we-are-mono/keyboard/assets/MONO65-logo.pdf

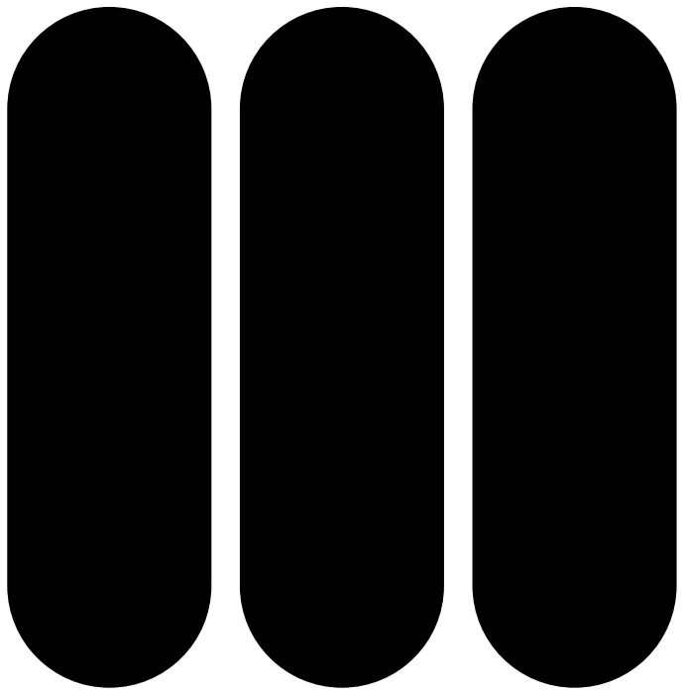
[picture p35: figure]
