we-are-mono/keyboard/electronics/MONO65/A2/fabricationFiles/BOM/MONO65_A2_BOM_NO_SWITCHES_Var_SCH/MONO65_A2_BOM_NO_SWITCHES_Var_SCH.pdf

Designator | Quantity | Description | Comment | Case/Package | Pins | Manufacturer | Manufacturer Part Number | Supplier 1 | Supplier Part Number 1
C1, C7, C8, C12, C13, C14, C15, C16 | 8 | SMD CAPACITOR,10u, 16V, X5R, 0603 | 10u 16V | 0603 | 2 | Murata | GRM188R61C106MA73D | Digi-Key | 490-7201-1-ND
C2, C4, C5, C6, C11 | 5 | SMD CAPACITOR, 100n, 50V, X7R, 0603 | 100n 50V | 0603 | 2 | TDK | CGA3E2X7R1H104K080AA | Digi-Key | 445-5666-1-ND
C3 | 1 | SMD CAPACITOR, 1µF, 25V, X7R, 0603 | 1u 25V | 0603 | 2 | KEMET | C0603C105K3RACTU | Digi-Key | 399-7376-1-ND
C9, C10 | 2 | SMD CAPACITOR, 22p, 50V, C0G/NP0, 0603 | 22p 50V | 0603 | 2 | Kyocera AVX | 06035A220JAT2A | Digi-Key | 478-1167-1-ND
D1, D2, D3, D4, D5, D6, D7, D8, D9, D10, D11, D12, D13, D14, D16, D17, D18, D19, D20, D21, D22, D23, D24, D25, D26, D27, D28, D29, D30, D32, D33, D35, D36, D37, D38, D39, D40, D41, D42, D43, D44, D45, D46, D48, D49, D50, D52, D53, D54, D55, D56, D57, D58, D59, D60, D61, D62, D63, D64, D65, D66, D68, D70, D72, D74, D75, D77, D78, D79 | 69 | Schottky Diode, Small Signal, Single, 40 V, 500 mA, 480 mV, 5A max. | SD0805S040 | 0805 | 2 | Kyocera AVX | SD0805S040S0R5 | Digi-Key | 478-7802-1-ND
F1 | 1 | PTC Resettable Fuse 0.5A (hold) 1A (trip) 15VDC 100A peak 0.6W 0.1sek 0.15Ohm SMD 1206 | 0.5A 15VDC | 1206 | 2 | Littelfuse | 1206L050/15YR | Digi-Key | F3733CT-ND
IC1 | 1 | MCU 8-bit AVR, 16MHz, 128KB Flash, 64-QFN 9x9mm (PS package) | AT90USB128 QFN-64 | | 65 | Microchip / Atmel | AT90USB1286-MU | RSComponents | 1278162
K1 | 1 | 4pin PHD 1mm SMD JST - SM04B-SRSS-TB - Pin Header, Wire-to-Board, 1 Rows, 4 Contacts, SR Series | SM04B-SRSS-TB | | 5 | JST | SM04B-SRSS-TB | Digi-Key | 455-1422-1-ND
Q1, Q2 | 2 | N-Channel MOSFET, 680 mA, 25 V, SOT-23-3, ON Semiconductor FDV303N | FDV303N | SOT-23 | 3 | ON Semiconductor / Fairchild | FDV303N | Digi-Key | FDV303NCT-ND
R1, R2 | 2 | SMD RESISTOR 22R 1% 0603 0.1W | 22R 1% | 0603 | 2 | Yageo | RC0603FR-0722RL | Digi-Key | 311-22.0HRCT-ND
R3, R5, R6, R7, R8, R10, R94 | 7 | SMD RESISTOR 0R 1% 0603 0.1W | 0R 1% | 0603 | 2 | Yageo | RC0603JR-070RL | Digi-Key | 311-0.0GRDKR-ND
R4, R9, R14, R16 | 4 | SMD RESISTOR 10k 1% 0603 0.1W | 10k 1% | 0603 | 2 | Panasonic | ERJ-3EKF1002V | Digi-Key | P10.0KHDKR-ND
R11, R13, R15, R17, R18, R19, R20, R21, R22, R23, R24, R25, R26, R27, R28, R29, R30, R32, R33, R34, R35, R36, R37, R38, R39, R40, R41, R42, R43, R44, R45, R46, R47, R48, R49, R50, R51, R52, R53, R54, R55, R56, R57, R58, R59, R61, R63, R64, R66, R67, R68, R69, R70, R71, R72, R73, R74, R75, R76, R77, R78, R79, R80, R82, R84, R86, R88, R89, R91, R92, R93 | 71 | SMD RESISTOR 470R 1% 0603 0.1W | 470R 1% | 0603 | 2 | Yageo | RC0603FR-07470RL | Digi-Key | 311-470HRCT-ND
SW80 | 1 | WS-TASV J-Bend SMT Tact Switch 3.7x3.7mm. 12 V (DC) 50mA. 500000 Cycles. | WS-TASV 3.7x3.7mm | | 4 | Wurth Electronics | 430173003816 | Mouser | 710-430173003816
XC1 | 1 | Crystal Resonator, 16MHz, 10pF, 3.2mm X 2.5mm, SMD | 16MHz 10ppmSMD 3225 | | 4 | Multicomp | MCSJK-7U-16.00-10-10-80-B-10 | Farnell | 2853934
