we-are-mono/keyboard/electronics/MONO65_DB/A1/fabricationFiles/BOM/MONO65_DB_A1_BOM_FULL_Var_SCH/MONO65_DB_A1_BOM_FULL_Var_SCH.pdf

Designator | Quantity | Description | Comment | Case/Package | Pins | Manufacturer | Manufacturer Part Number | Supplier 1 | Supplier Part Number 1
C1 | 1 | SMD CAPACITOR, 4.7n, 1kV, X7R, 0805 | 4n7 1kV | 0805 | 2 | KEMET | C0805C472KDRACTU | Farnell | 3299100
D1 | 1 | TVS ESD DIODE - PRTR5V0U2X - Ultra low capacitance double rail-to-rail ESD protection diode | PRTR5V0U2X,215 | SOT143B | 4 | Nexperia | PRTR5V0U2X,215 | Digi-Key | 1727-3884-6-ND
F1 | 1 | PTC Resettable Fuse 1.1A(hold) 2.2A(trip) 16VDC 100A 0.8W 0.1sek 0.06Ohm SMD 1206 | 1.1A 16VDC PTC | 1206 | 2 | Littelfuse | 1206L110/16WR | Digi-Key | 18-1206L110/16WRCT-ND
K1 | 1 | USB2.0 Type-C 24P SMD Right Angle SMD | USB-C | | 13 | Molex | 217179-0001 | Avnet | 35AJ1973
K2 | 1 | 4pin PHD 1mm SMD JST - SM04B-SRSS-TB - Pin Header, Wire-to-Board, 1 Rows, 4 Contacts, SR Series SM04B-SRSS-TB | | | 5 | JST | SM04B-SRSS-TB | Digi-Key | 455-1422-1-ND
R1, R2 | 2 | SMD RESISTOR 5.1k 1% 0603 0.1W | 5k1 1% | 0603 | 2 | Yageo | RC0603FR-075K1L | Farnell | 3495881
R3 | 1 | SMD RESISTOR 1M 1% 0603 0.1W | 1M 1% | 0603 | 2 | Yageo | RC0603FR-071ML | Digi-Key | 311-1.00MHRCT-ND
