we-are-mono/keyboard/electronics/MONO65/A2/fabricationFiles/3D step/MONO65_A2_3D_step_FULL_Var_SCH.step

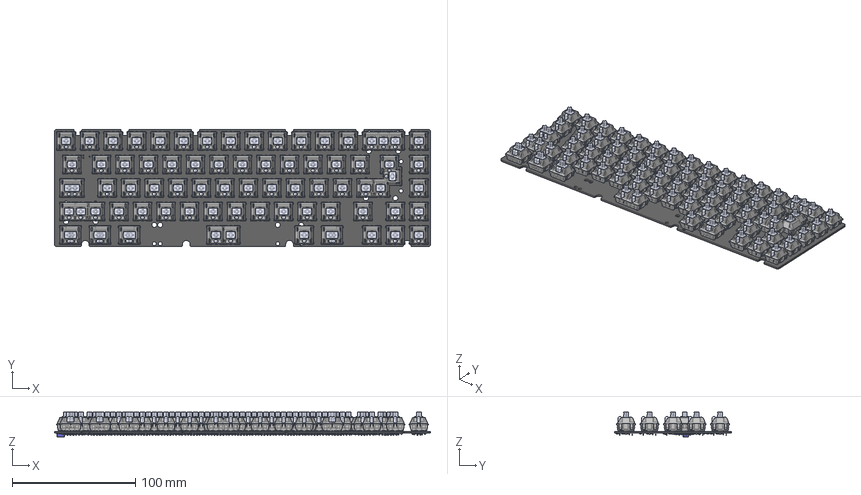
[picture p36: CAD file, 2025-07-09]
electronics/MONO65/A2/fabricationFiles/3D step/MONO65_A2_3D_step_FULL_Var_SCH.step
304.6 x 95.1 x 20.1 mm
Open_CASCADE_STEP_translator_6.8_2.1.1 x 16
Open_CASCADE_STEP_translator_6.8_2.1.2 x 16
Open_CASCADE_STEP_translator_6.8_2.2.1 x 16
Mid_Body x 84
Open_CASCADE_STEP_translator_6.8_1.2.1 x 168
Mark x 84
Housing x 5
pressure_plate
Open_CASCADE_STEP_translator_6.8_7.1.1 x 2
Leader x 6
User_Library-D0805 x 69
User_Library-SMD-3225_4P
SM04B-SRSS-TB
User_Library-0ZCJ0035FF2G
Open_CASCADE_STEP_translator_6.8_21.1
Open_CASCADE_STEP_translator_6.8_21.2.1
Thermal_Shape
Open_CASCADE_STEP_translator_6.8_21.4.1 x 64
MX_Series-Cherry_Key x 79
