we-are-mono/keyboard/assets/MONO65-logo.dxf

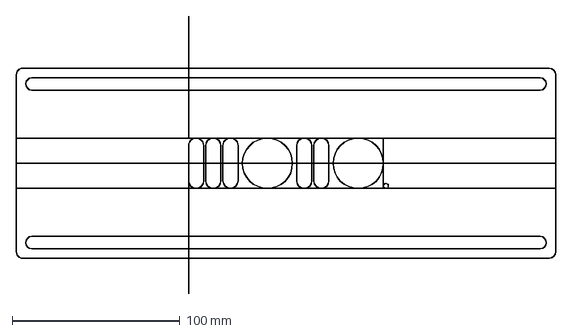
[picture p37: CAD file, 2025-07-09]
assets/MONO65-logo.dxf
321.8 x 165.4 mm
