we-are-mono/keyboard/enclosure/MONO65-keyboard-cover.step

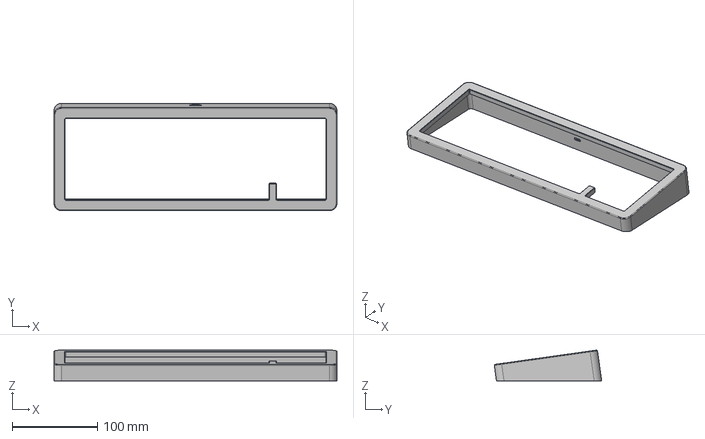
[picture p39: CAD file, 2025-07-09]
enclosure/MONO65-keyboard-cover.step
331.8 x 126.0 x 36.1 mm
