we-are-mono/keyboard/feet-gaskets/MONO65-keyboard-gasket.dxf

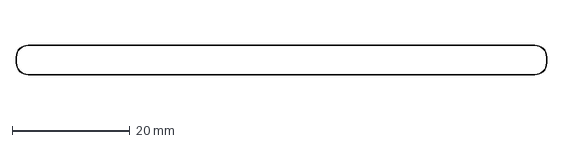
[picture p40: CAD file, 2025-07-09]
feet-gaskets/MONO65-keyboard-gasket.dxf
90.1 x 5.00 mm
