we-are-mono/keyboard/enclosure/MONO65-keyboard-bottom.step

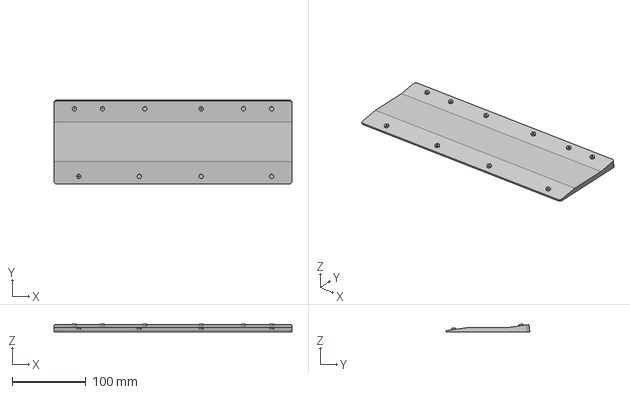
[picture p41: CAD file, 2025-07-09]
enclosure/MONO65-keyboard-bottom.step
321.8 x 113.6 x 11.2 mm
