we-are-mono/keyboard/enclosure/MONO65-keyboard-middle.step

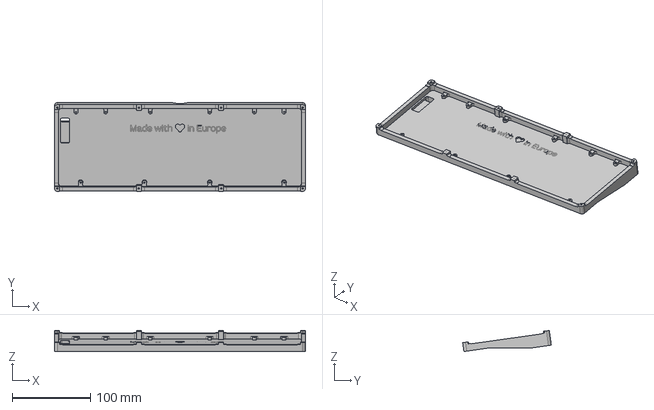
[picture p42: CAD file, 2025-07-09]
enclosure/MONO65-keyboard-middle.step
321.8 x 113.8 x 27.0 mm
