we-are-mono/keyboard/(list of files, cad)

Other CAD files:
enclosure/MONO65-keyboard-bottom.iges
enclosure/MONO65-keyboard-cover.iges
enclosure/MONO65-keyboard-middle.iges
