we-are-mono/keyboard/electronics/MONO65_JST_CAB/A1/fabricationFiles/MONO-65-JST-Cable-4-wires-180-mm.pdf

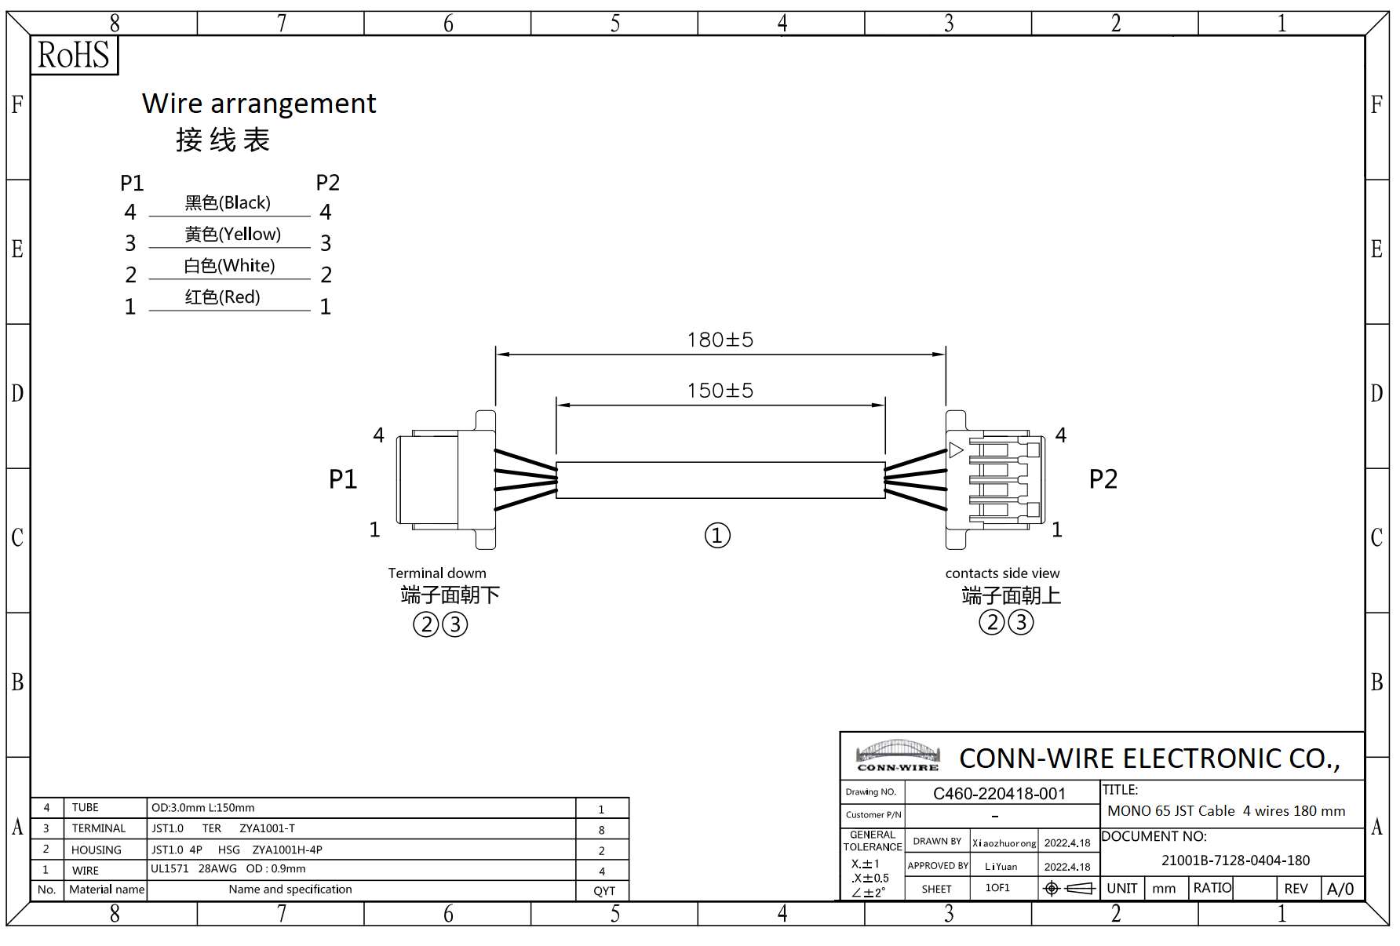
[picture p43: page 1]
