we-are-mono/keyboard/electronics/MONO65_JST_CAB/A1/fabricationFiles/MONO65_JST_CAB_A1_cable_specification.pdf

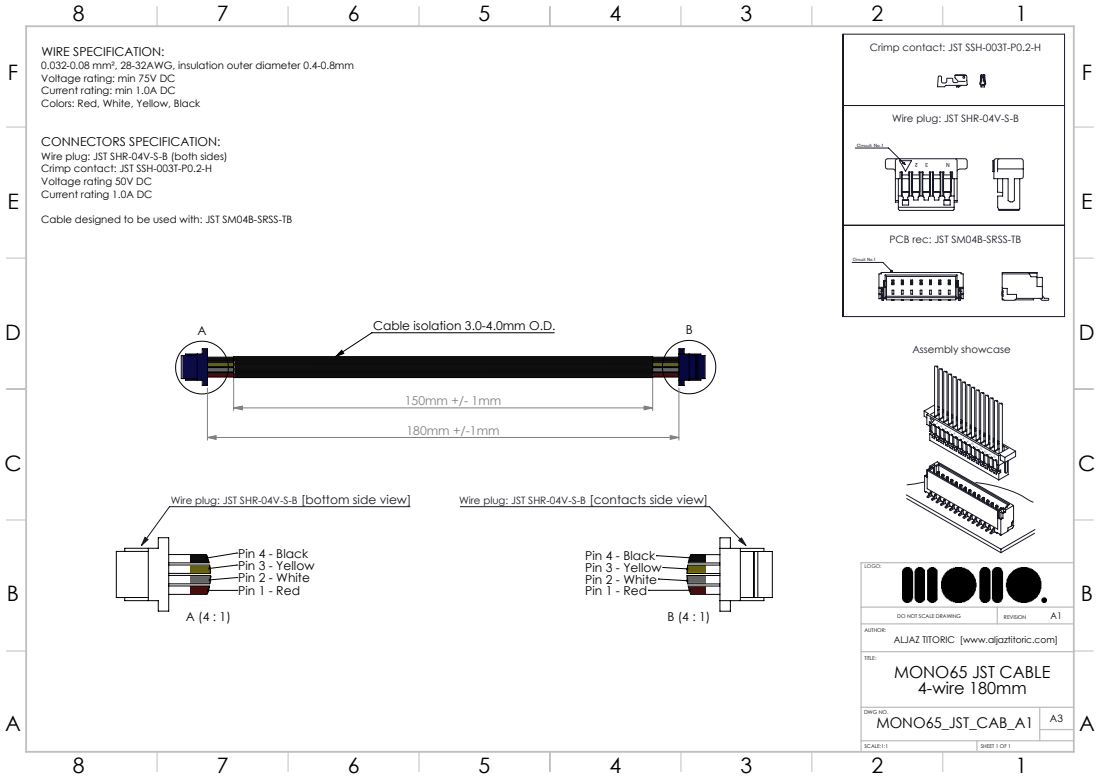
[picture p44: page 1]
Circuit No.1; Cable isolation 3.0-4.0mm O.D.; Pin 4 - Black Pin 3 - Yellow Pin 2 - White Pin 1 - Red; Pin 1 - Red; Pin 2 - White; Pin 3 - Yellow; Pin 4 - Black; Assembly showcase; Wire plug: JST SHR-04V-S-B [bottom side view]; Wire plug: JST SHR-04V-S-B [contacts side view]; DO NOT SCALE DRAWING; REVISION; DWG NO.; SCALE:1:1; SHEET 1 OF 1

Crimp contact: JST SSH-003T-P0.2-H

WIRE SPECIFICATION:
0.032-0.08 mm², 28-32AWG, insulation outer diameter 0.4-0.8mm
Voltage rating: min 75V DC
Current rating: min 1.0A DC
Colors: Red, White, Yellow, Black

Wire plug: JST SHR-04V-S-B

CONNECTORS SPECIFICATION:
Wire plug: JST SHR-04V-S-B (both sides)
Voltage rating 50V DC
Current rating 1.0A DC
Cable designed to be used with: JST SM04B-SRSS-TB

PCB rec: JST SM04B-SRSS-TB

ALJAZ TITORIC [www.aljaztitoric.com]
MONO65 JST CABLE
4-wire 180mm
