we-are-mono/keyboard/electronics/MONO65/A2/fabricationFiles/Schematic/MONO65_A2_Schematic_NO_SWITCHES_Var_SCH/MONO65_A2_Schematic_NO_SWITCHES_Var_SCH.PDF

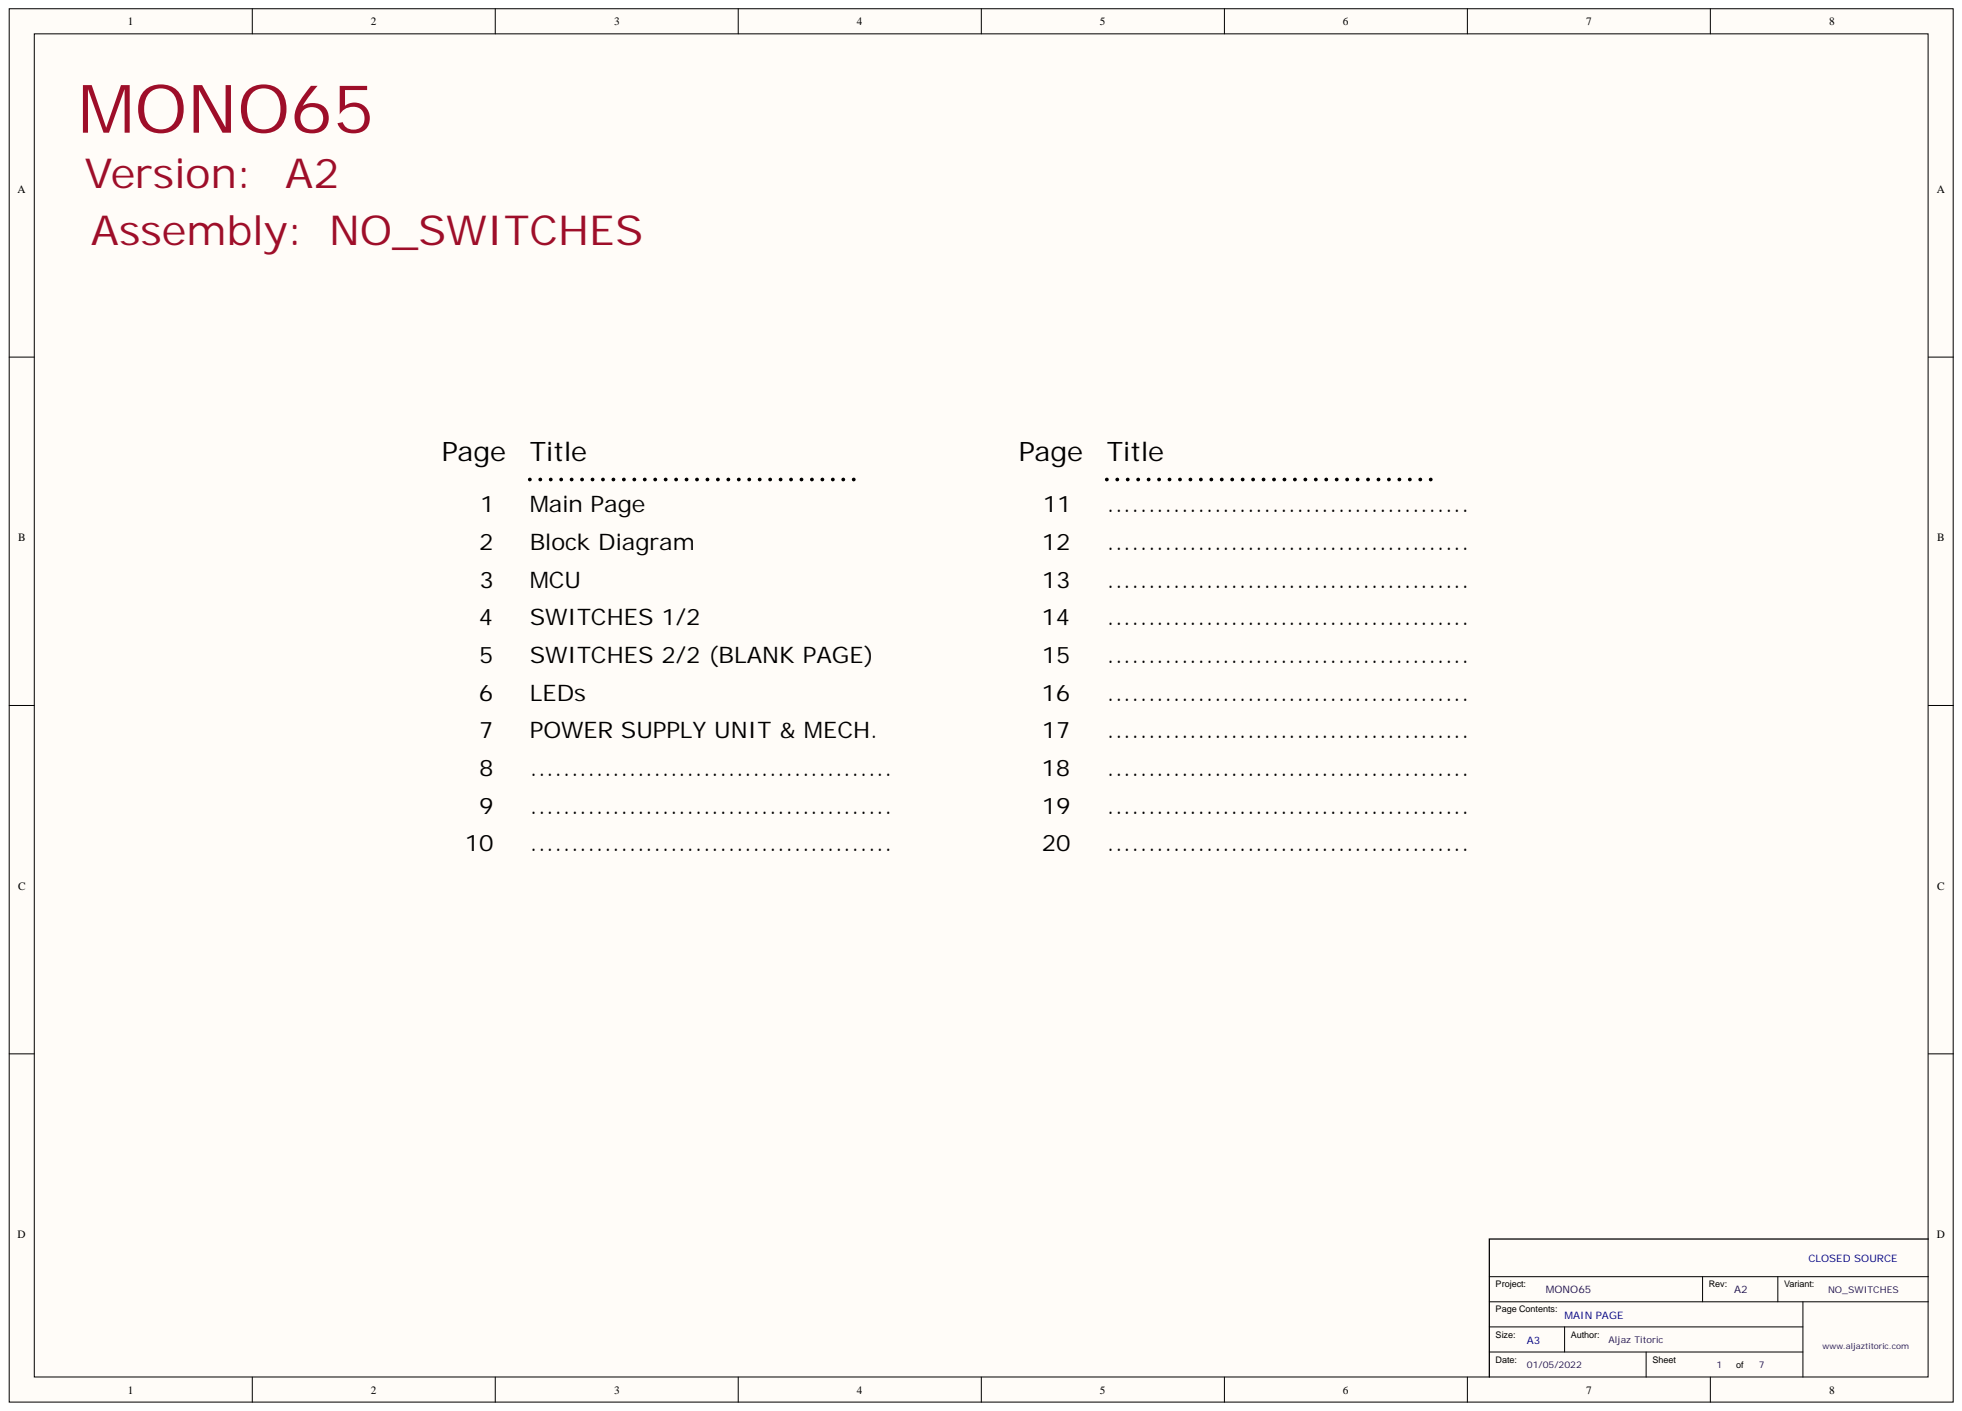
[picture p45: page 1]

Project: MONO65 | Rev: A2 | Variant: NO_SWITCHES

Page Contents: MAIN PAGE | www.aljaztitoric.com

A3 Size: | Author: Aljaz Titoric

Date: | Sheet 1 of 7

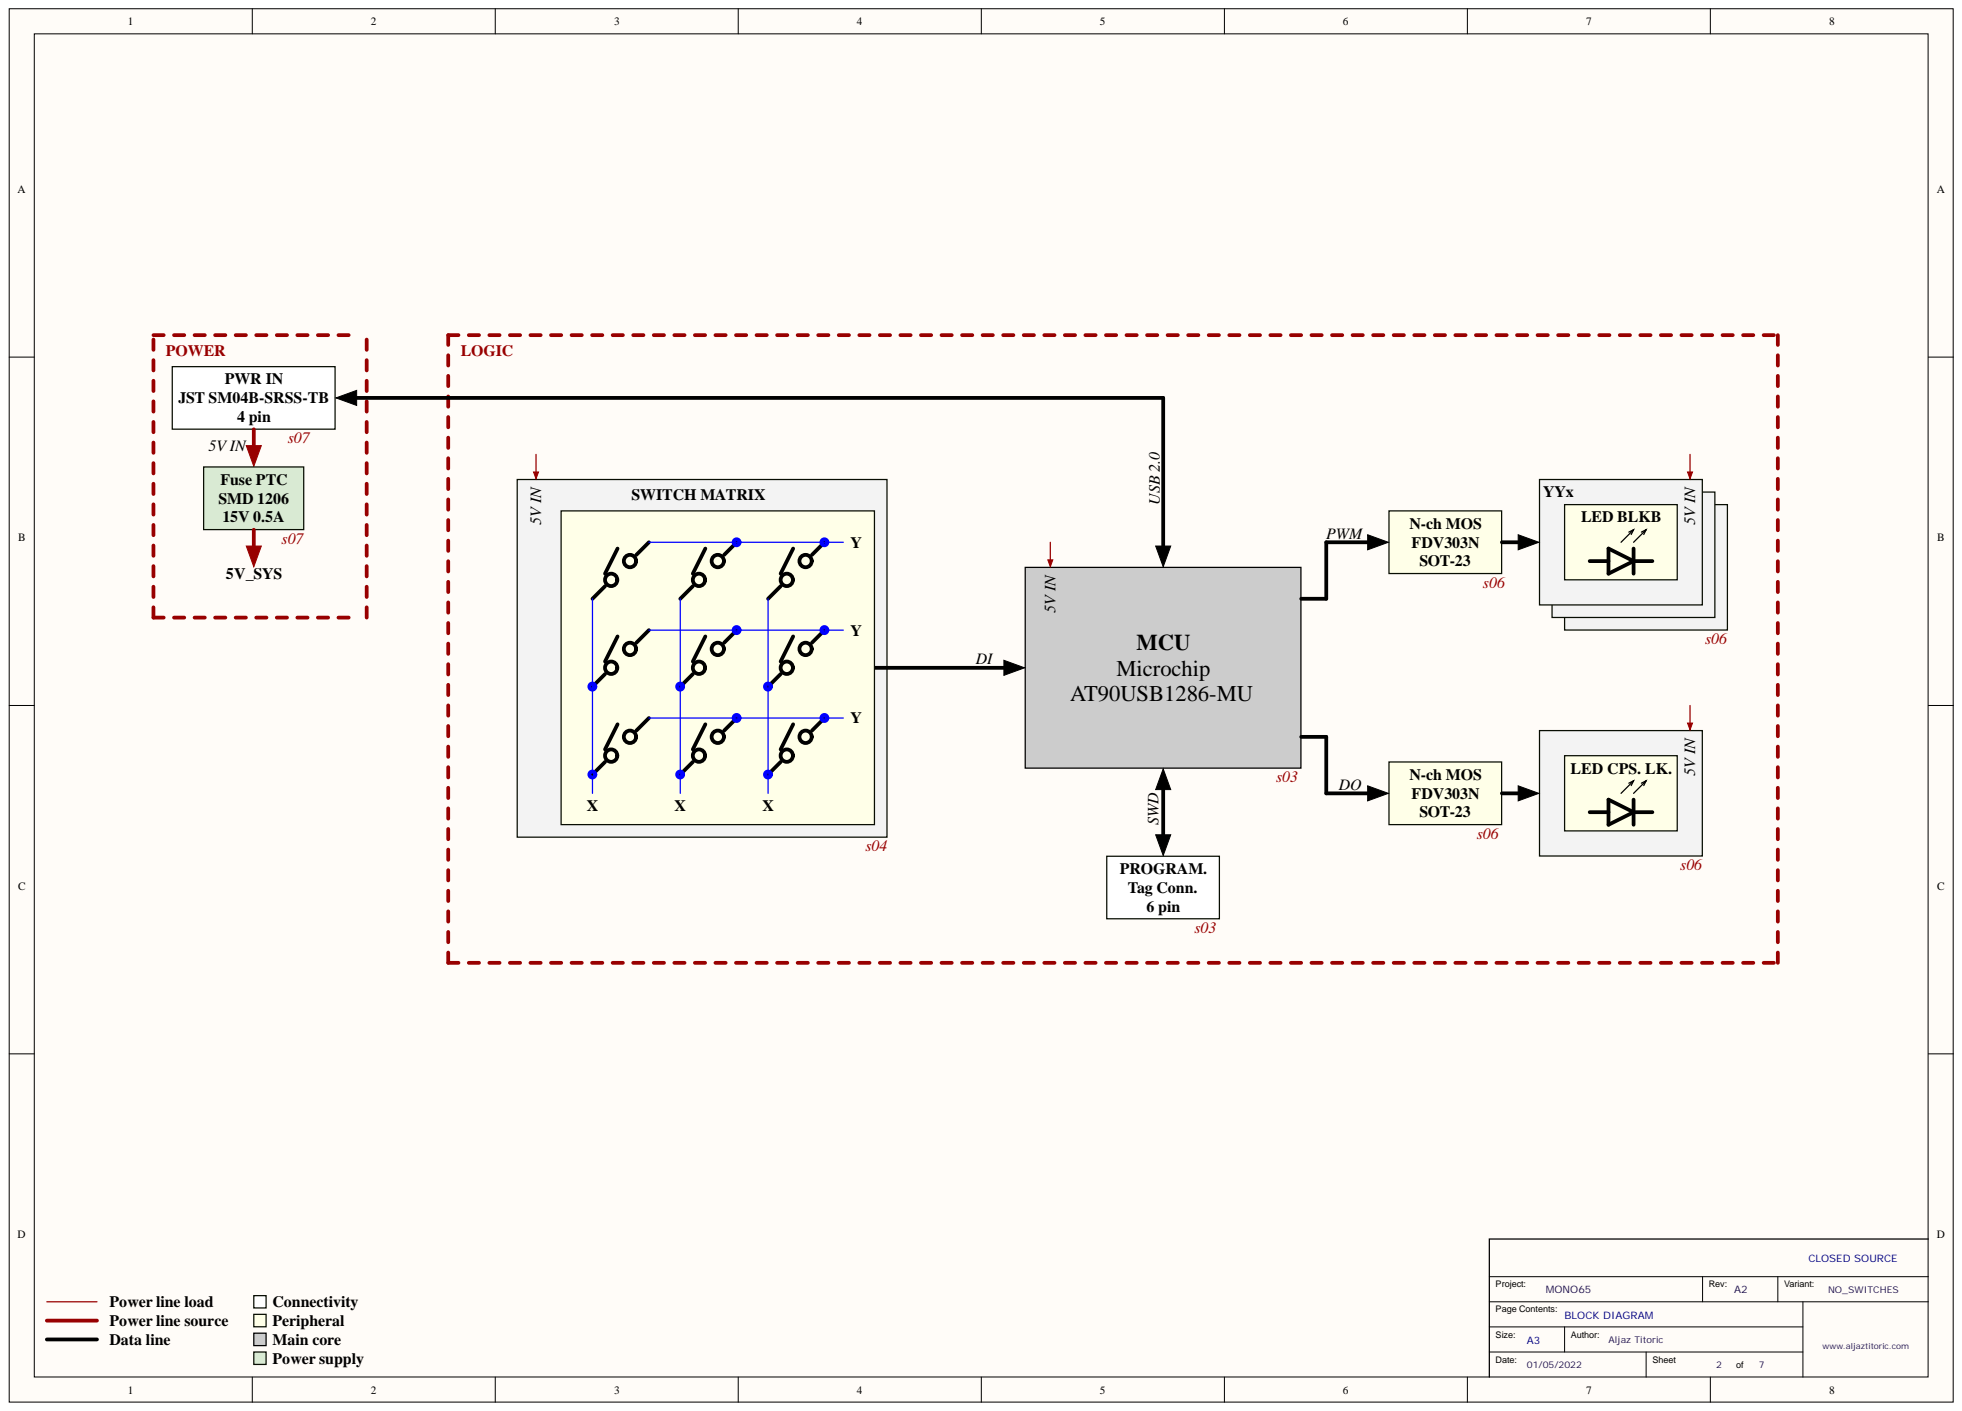
[picture p46: page 2]

Project: MONO65 | Rev: A2 | Variant: NO_SWITCHES

BLOCK DIAGRAM

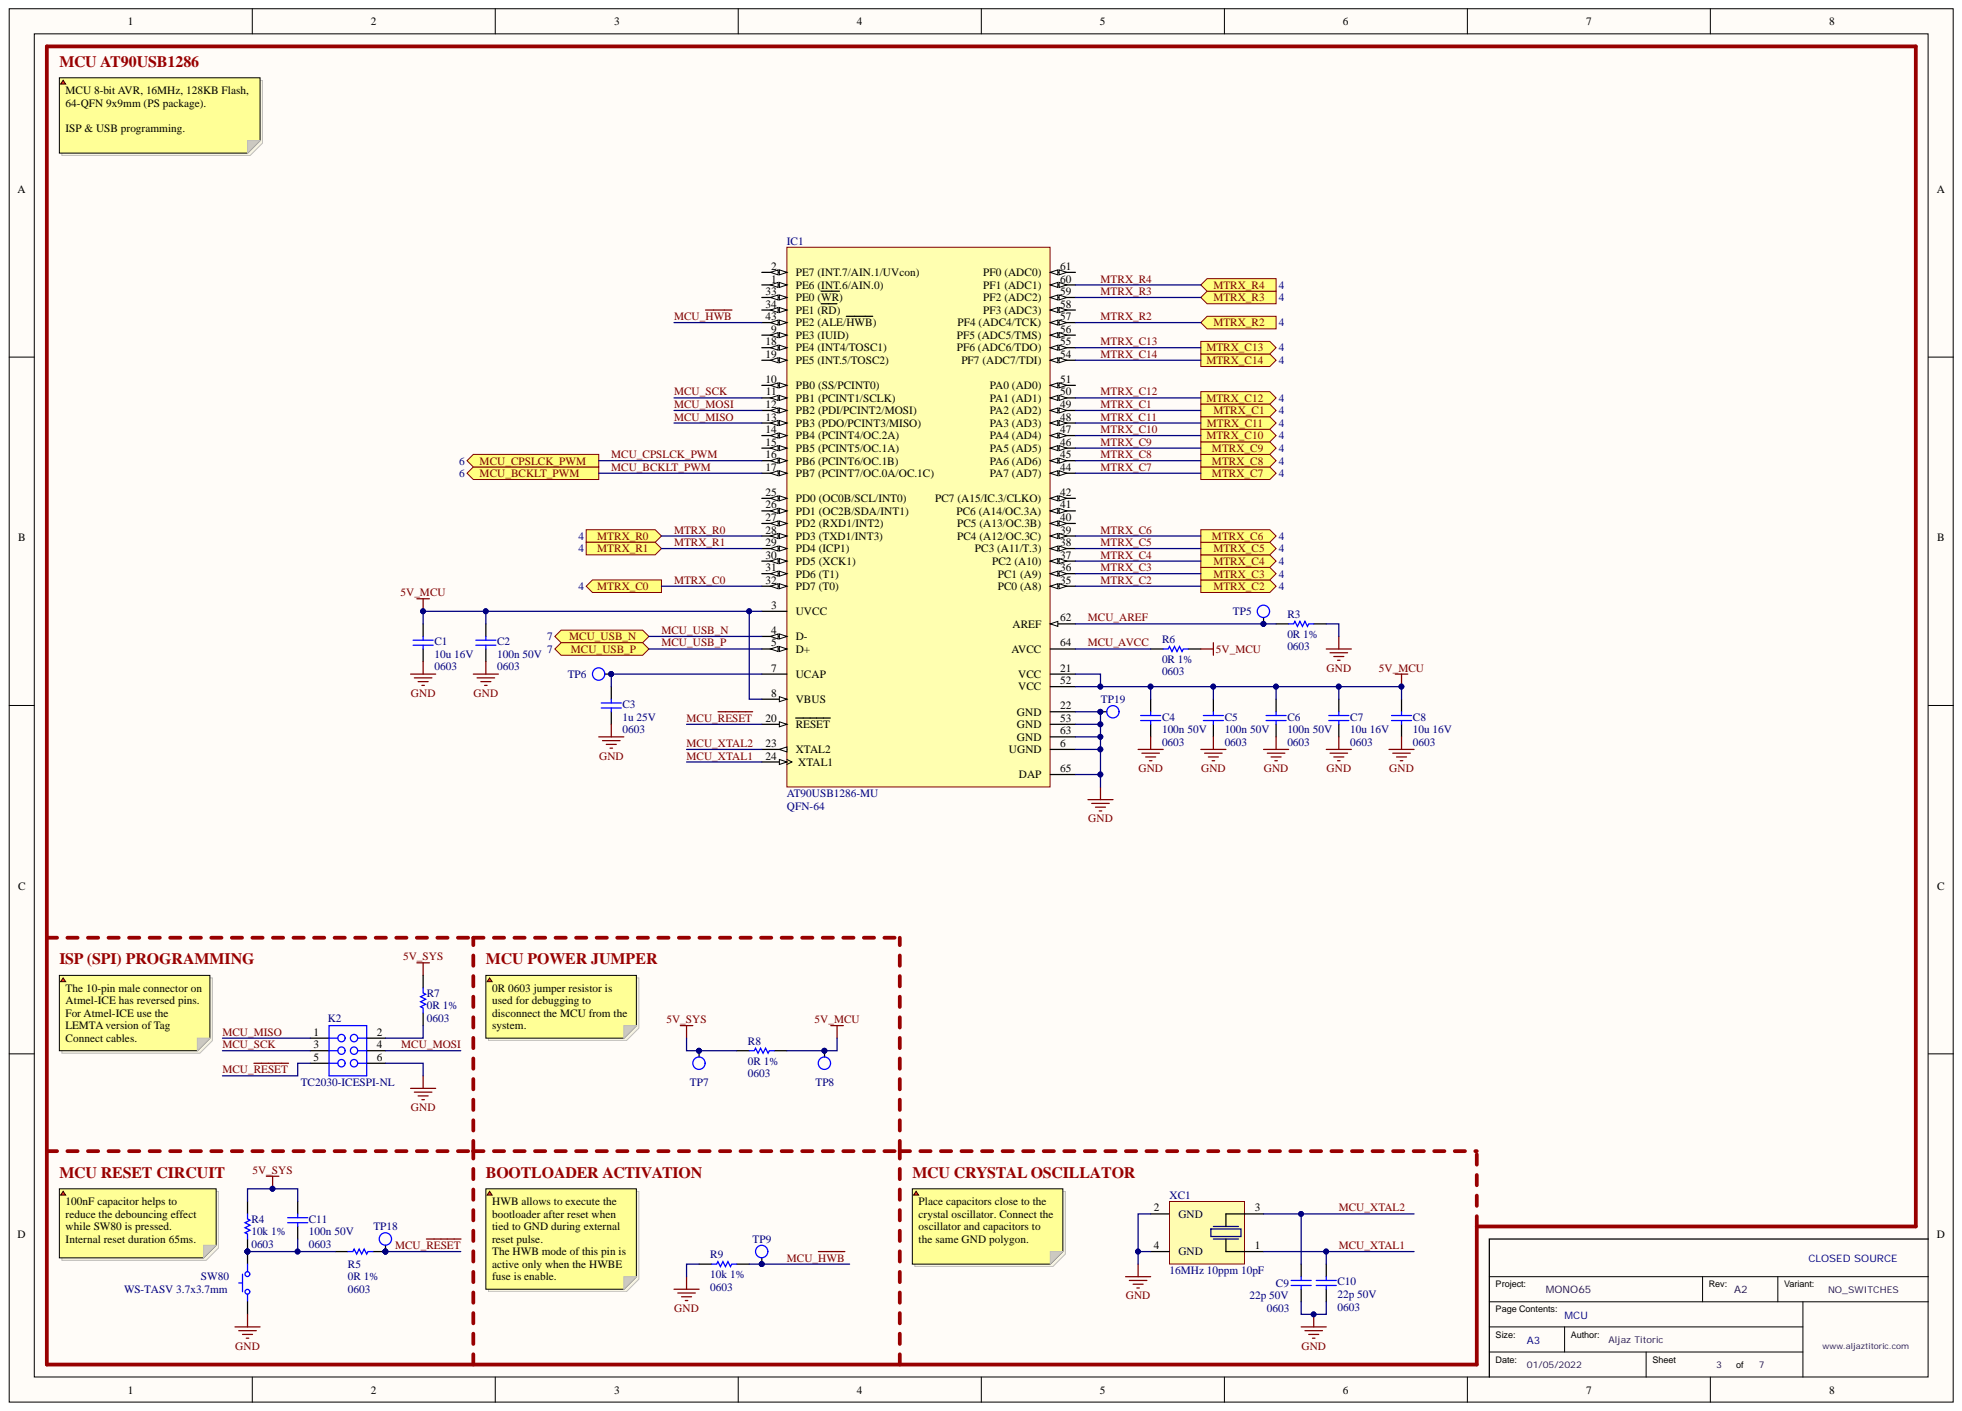
[picture p47: page 3]

MCU 8-bit AVR, 16MHz, 128KB Flash,
64-QFN 9x9mm (PS package).

The 10-pin male connector on
Atmel-ICE has reversed pins.
For Atmel-ICE use the
LEMTA version of Tag
Connect cables.

0R 0603 jumper resistor is
used for debugging to
disconnect the MCU from the
system.

100nF capacitor helps to
reduce the debouncing effect
while SW80 is pressed.
Internal reset duration 65ms.

HWB allows to execute the
bootloader after reset when
tied to GND during external
reset pulse.
The HWB mode of this pin is
active only when the HWBE
fuse is enable.

Place capacitors close to the
crystal oscillator. Connect the
oscillator and capacitors to
the same GND polygon.

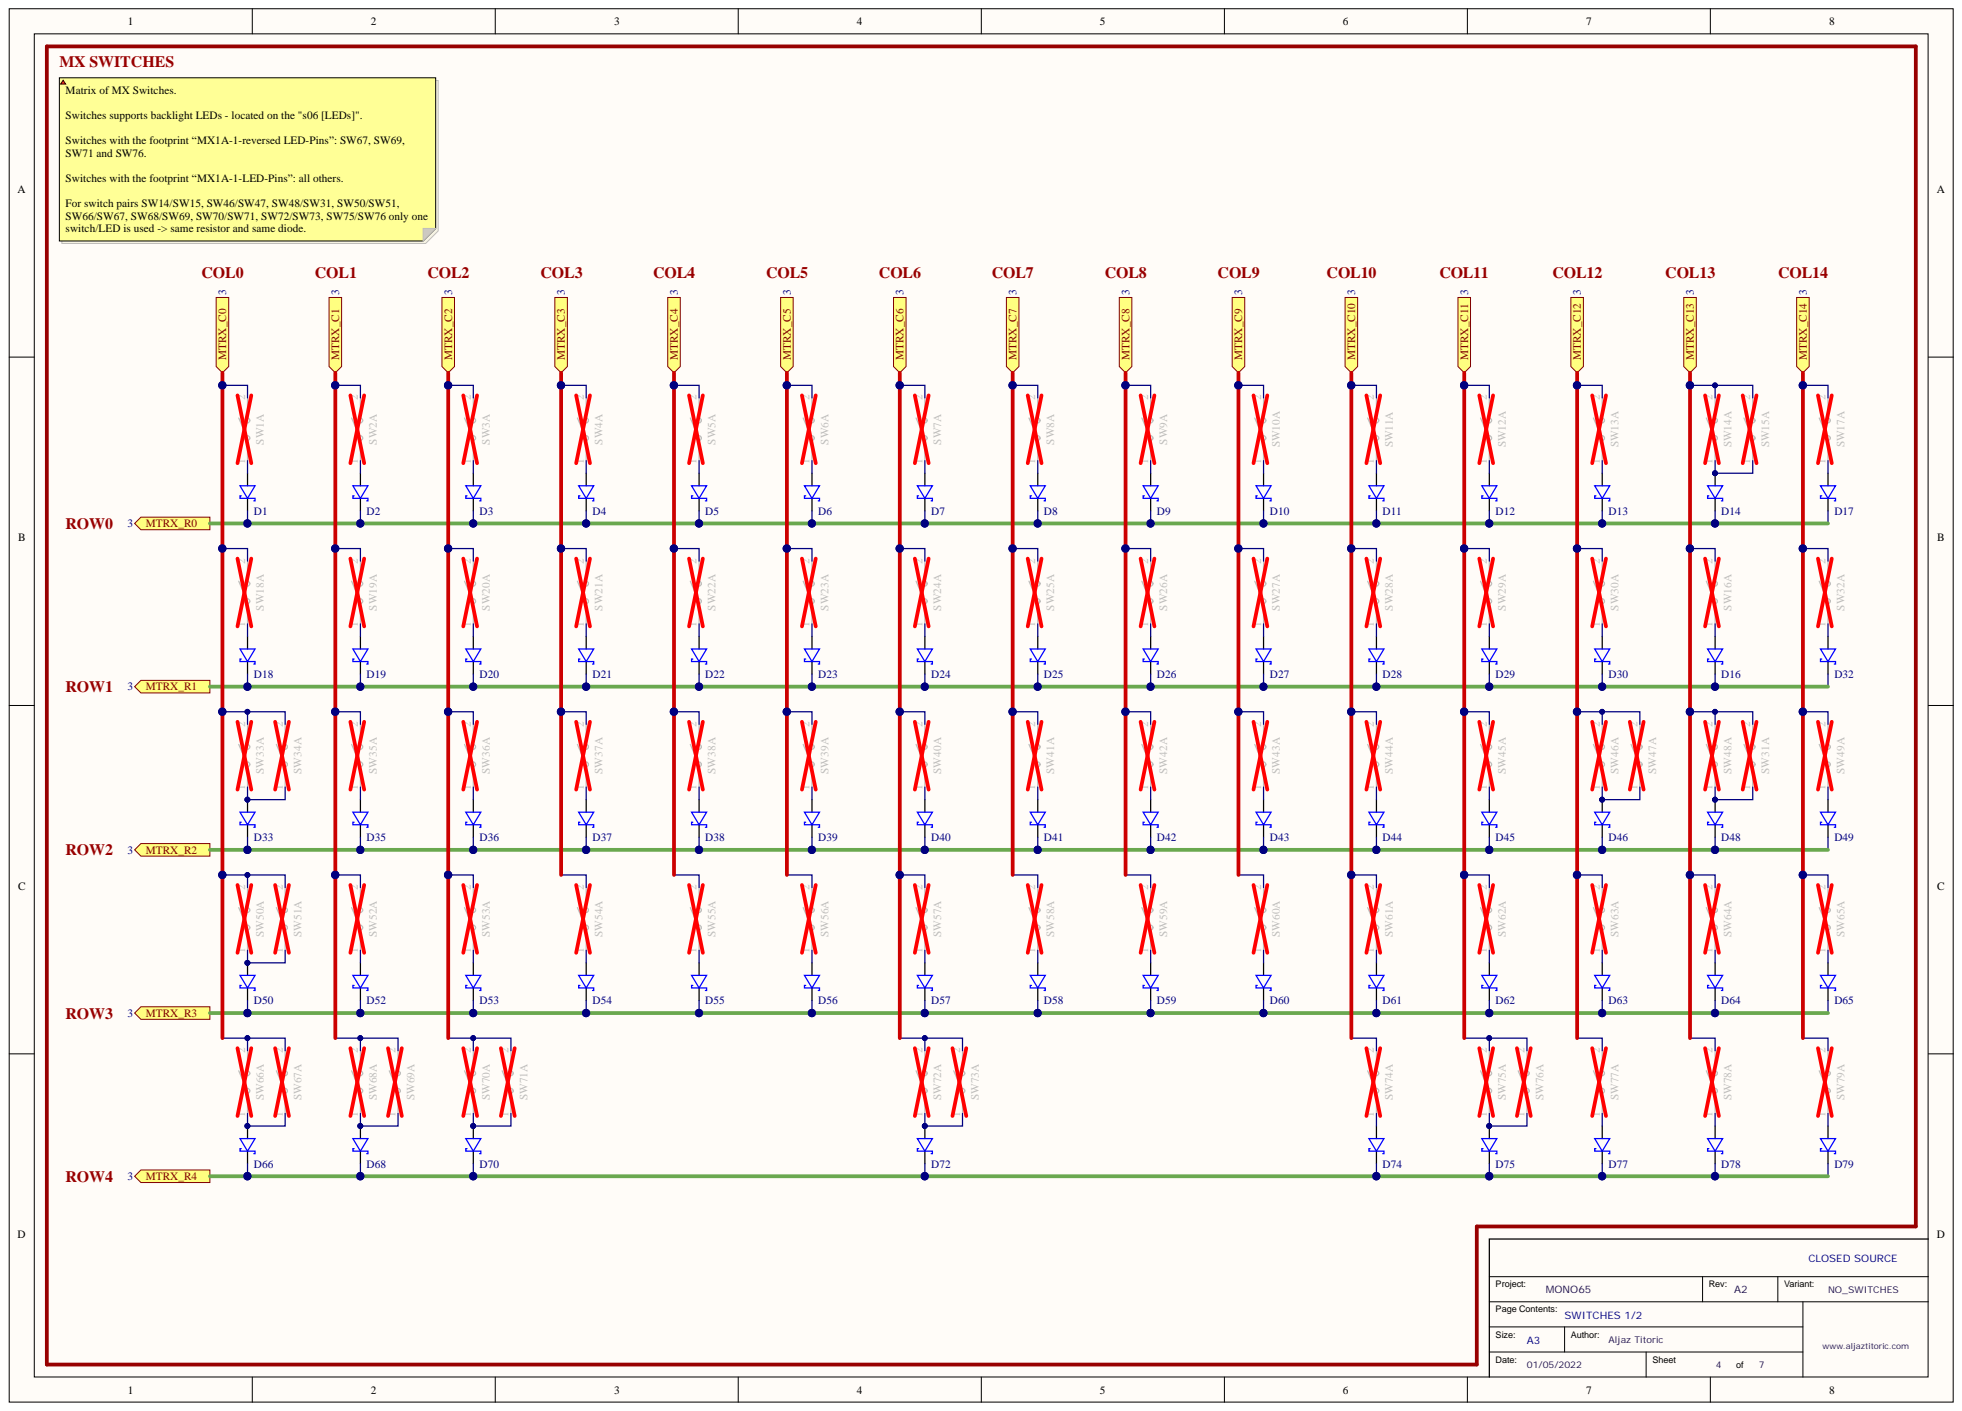
[picture p48: page 4]

Matrix of MX Switches.

Switches supports backlight LEDs - located on the "s06 [LEDs]".

Switches with the footprint
SW71 and SW76.

For switch pairs SW14/SW15, SW46/SW47, SW48/SW31, SW50/SW51,
SW66/SW67, SW68/SW69, SW70/SW71, SW72/SW73, SW75/SW76 only one
switch/LED is used -> same resistor and same diode.

Projec t : MONO6 5 | Rev : A2 | Variant : NO_S WITCHES

Page Content s : SW ITCHES 1/2

A ljaz Titori c

Date:

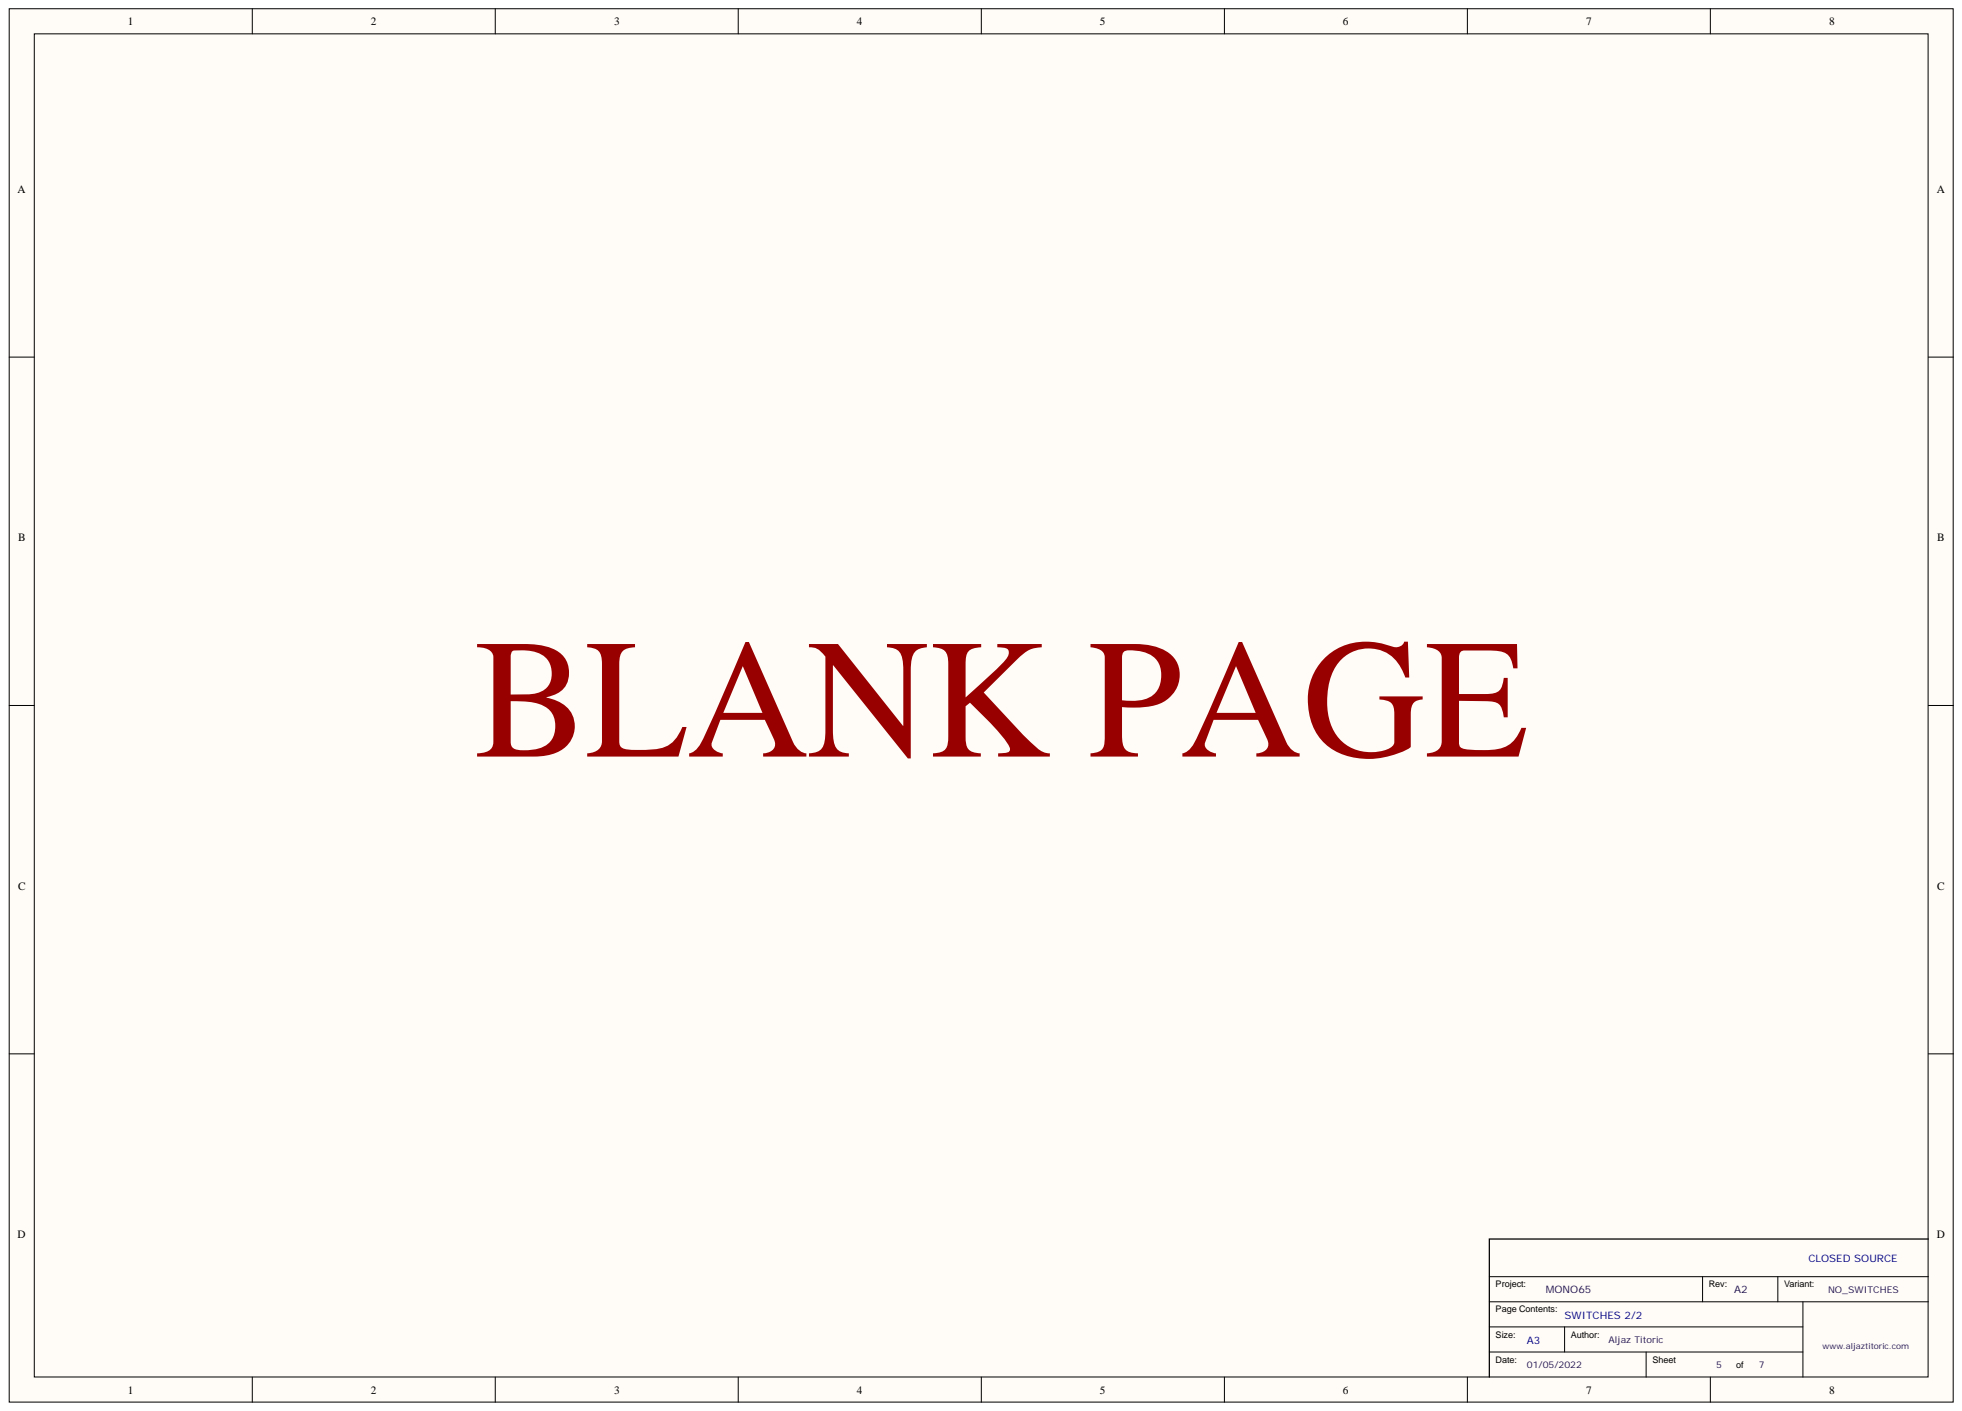
[picture p49: page 5]

Project: MONO65 | Rev: A2 | Variant: NO_SWITCHES

SWITCHES 2/2

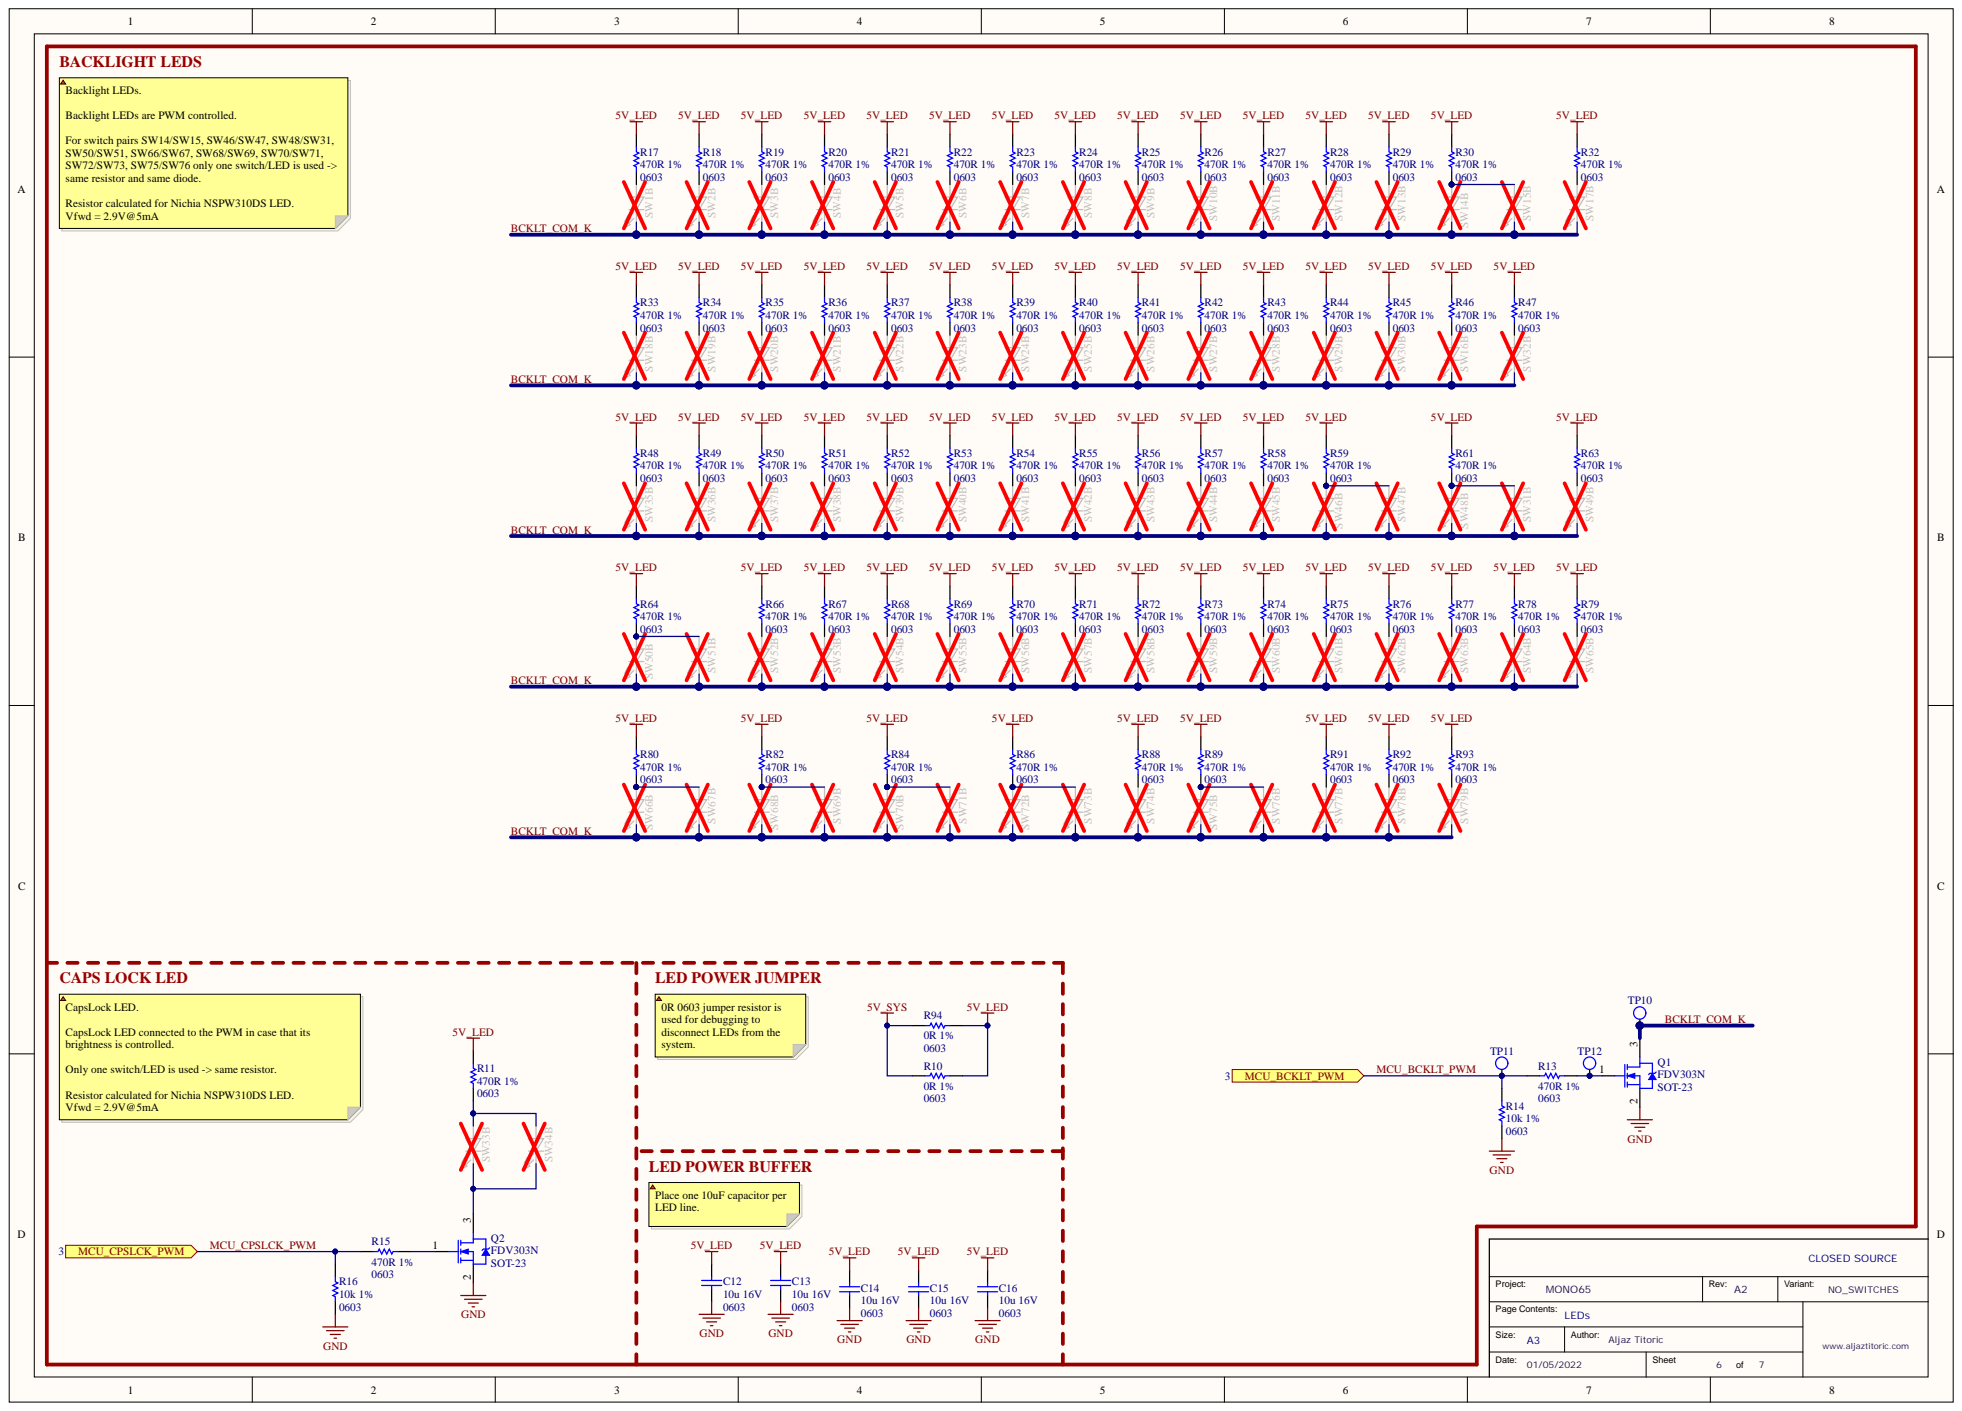
[picture p50: page 6]

Backlight LEDs are PWM controlled.

For switch pairs SW14/SW15, SW46/SW47, SW48/SW31,
SW72/SW73, SW75/SW76 only one switch/LED is used ->
same resistor and same diode.

Resistor calculated for Nichia NSPW310DS LED.
Vfwd = 2.9V@5mA

0R 0603 jumper resistor is
used for debugging to
disconnect LEDs from the
system.

CapsLock LED connected to the PWM in case that its
brightness is controlled.

Only one switch/LED is used -> same resistor.

Place one 10uF capacitor per
LED line.

Project: MONO65 | Rev: A2 | Variant: NO_SWITCHES

LEDs

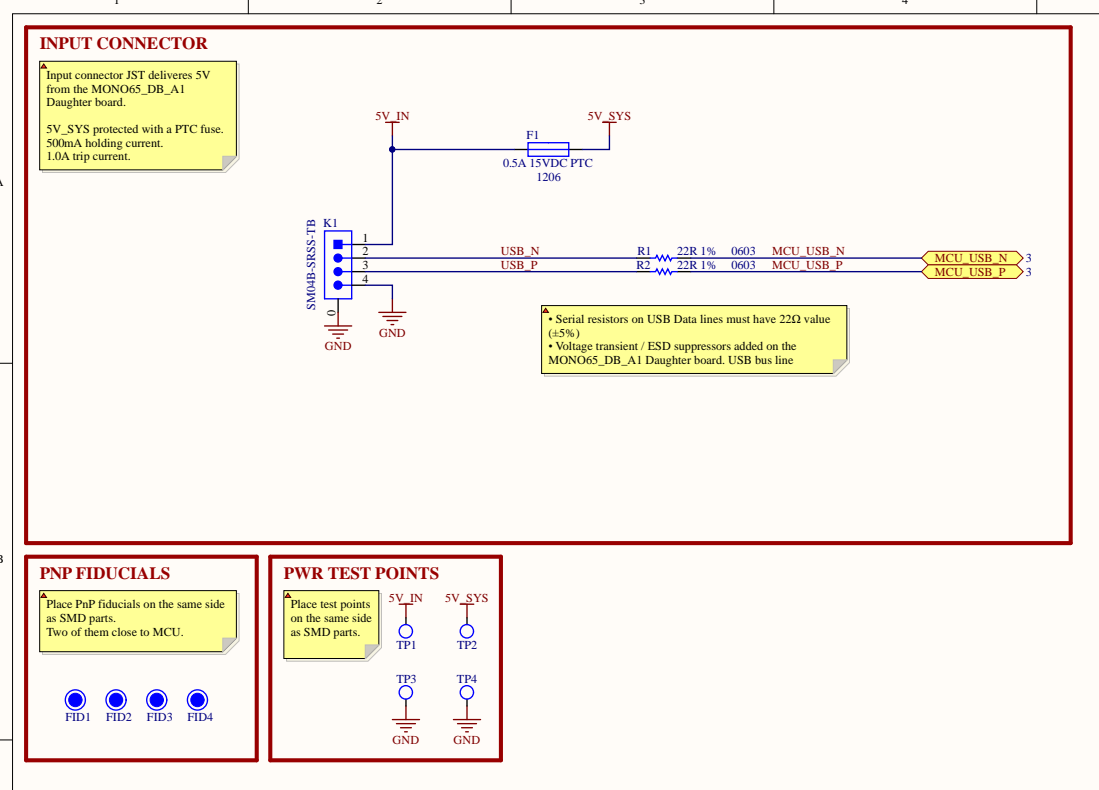
[picture p51: page 7]

Input connector JST deliveres 5V
from the MONO65_DB_A1
Daughter board.

5V_SYS protected with a PTC fuse.
500mA holding current.
1.0A trip current.

• Serial resistors on USB Data lines must have 22Ω value
• Voltage transient / ESD suppressors added on the
MONO65_DB_A1 Daughter board. USB bus line

Place PnP fiducials on the same side
as SMD parts.
Two of them close to MCU.

Place test points
on the same side

Project: MONO65 | Rev: A2 | Variant: NO_SWITCHES

POWER SUPPLY UNIT & MECHANICAL
