we-are-mono/keyboard/electronics/MONO65_DB/A1/fabricationFiles/Schematic/MONO65_DB_A1_Schematic_FULL_Var_SCH/MONO65_DB_A1_Schematic_FULL_Var_SCH.pdf

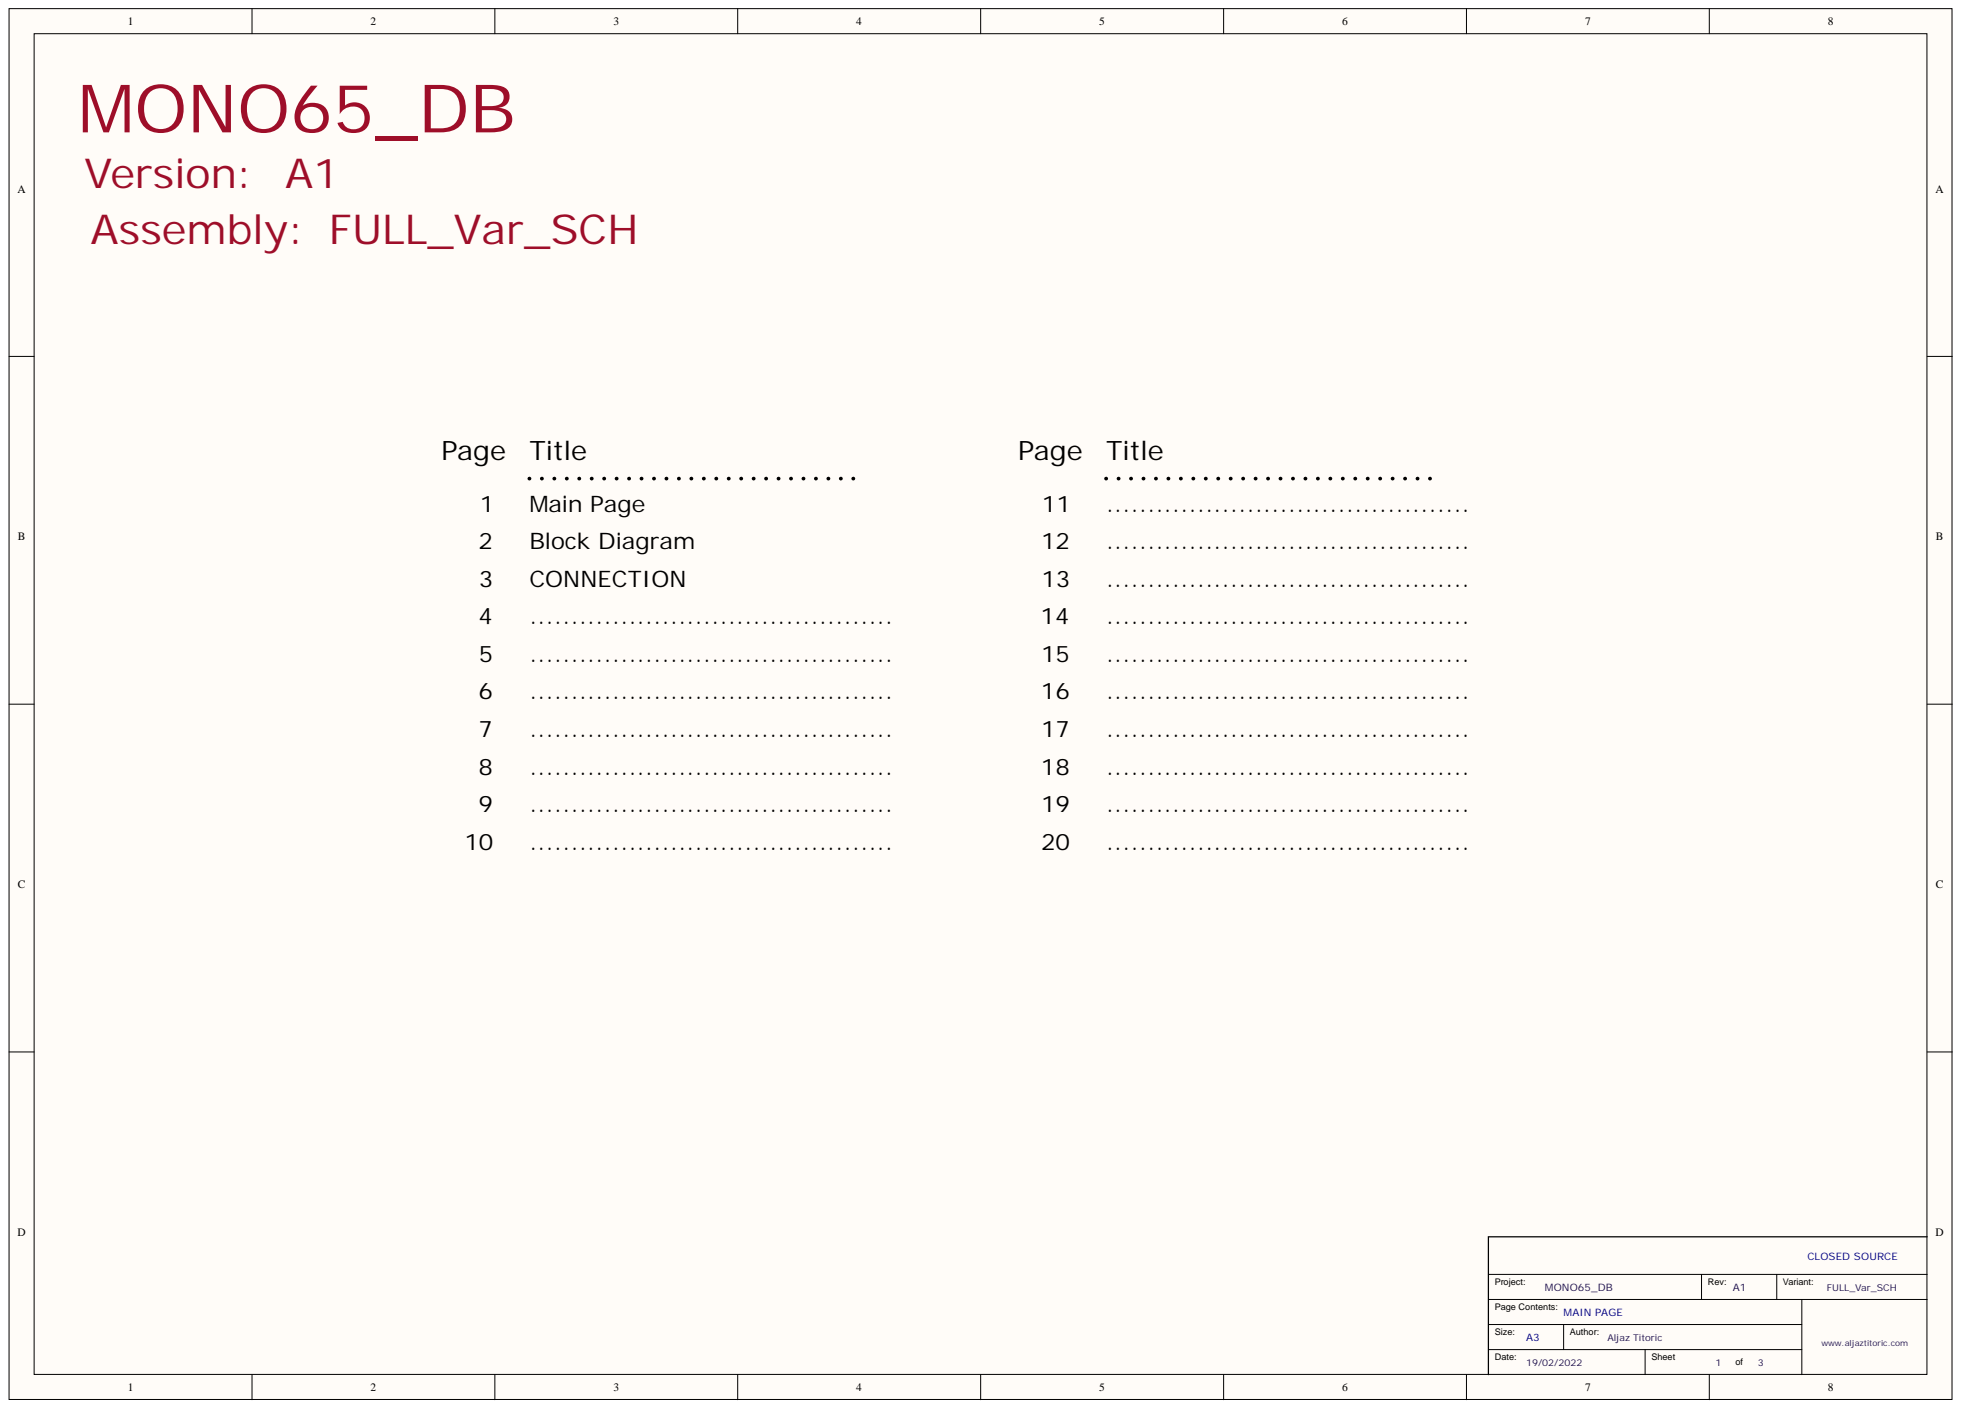
[picture p52: page 1]

Project: MONO65_DB | Rev: A1 | Variant: FULL_Var_SCH

Page Contents: MAIN PAGE | www.aljaztitoric.com

A3 Size: | Author: Aljaz Titoric

Date: | Sheet 1 of 3

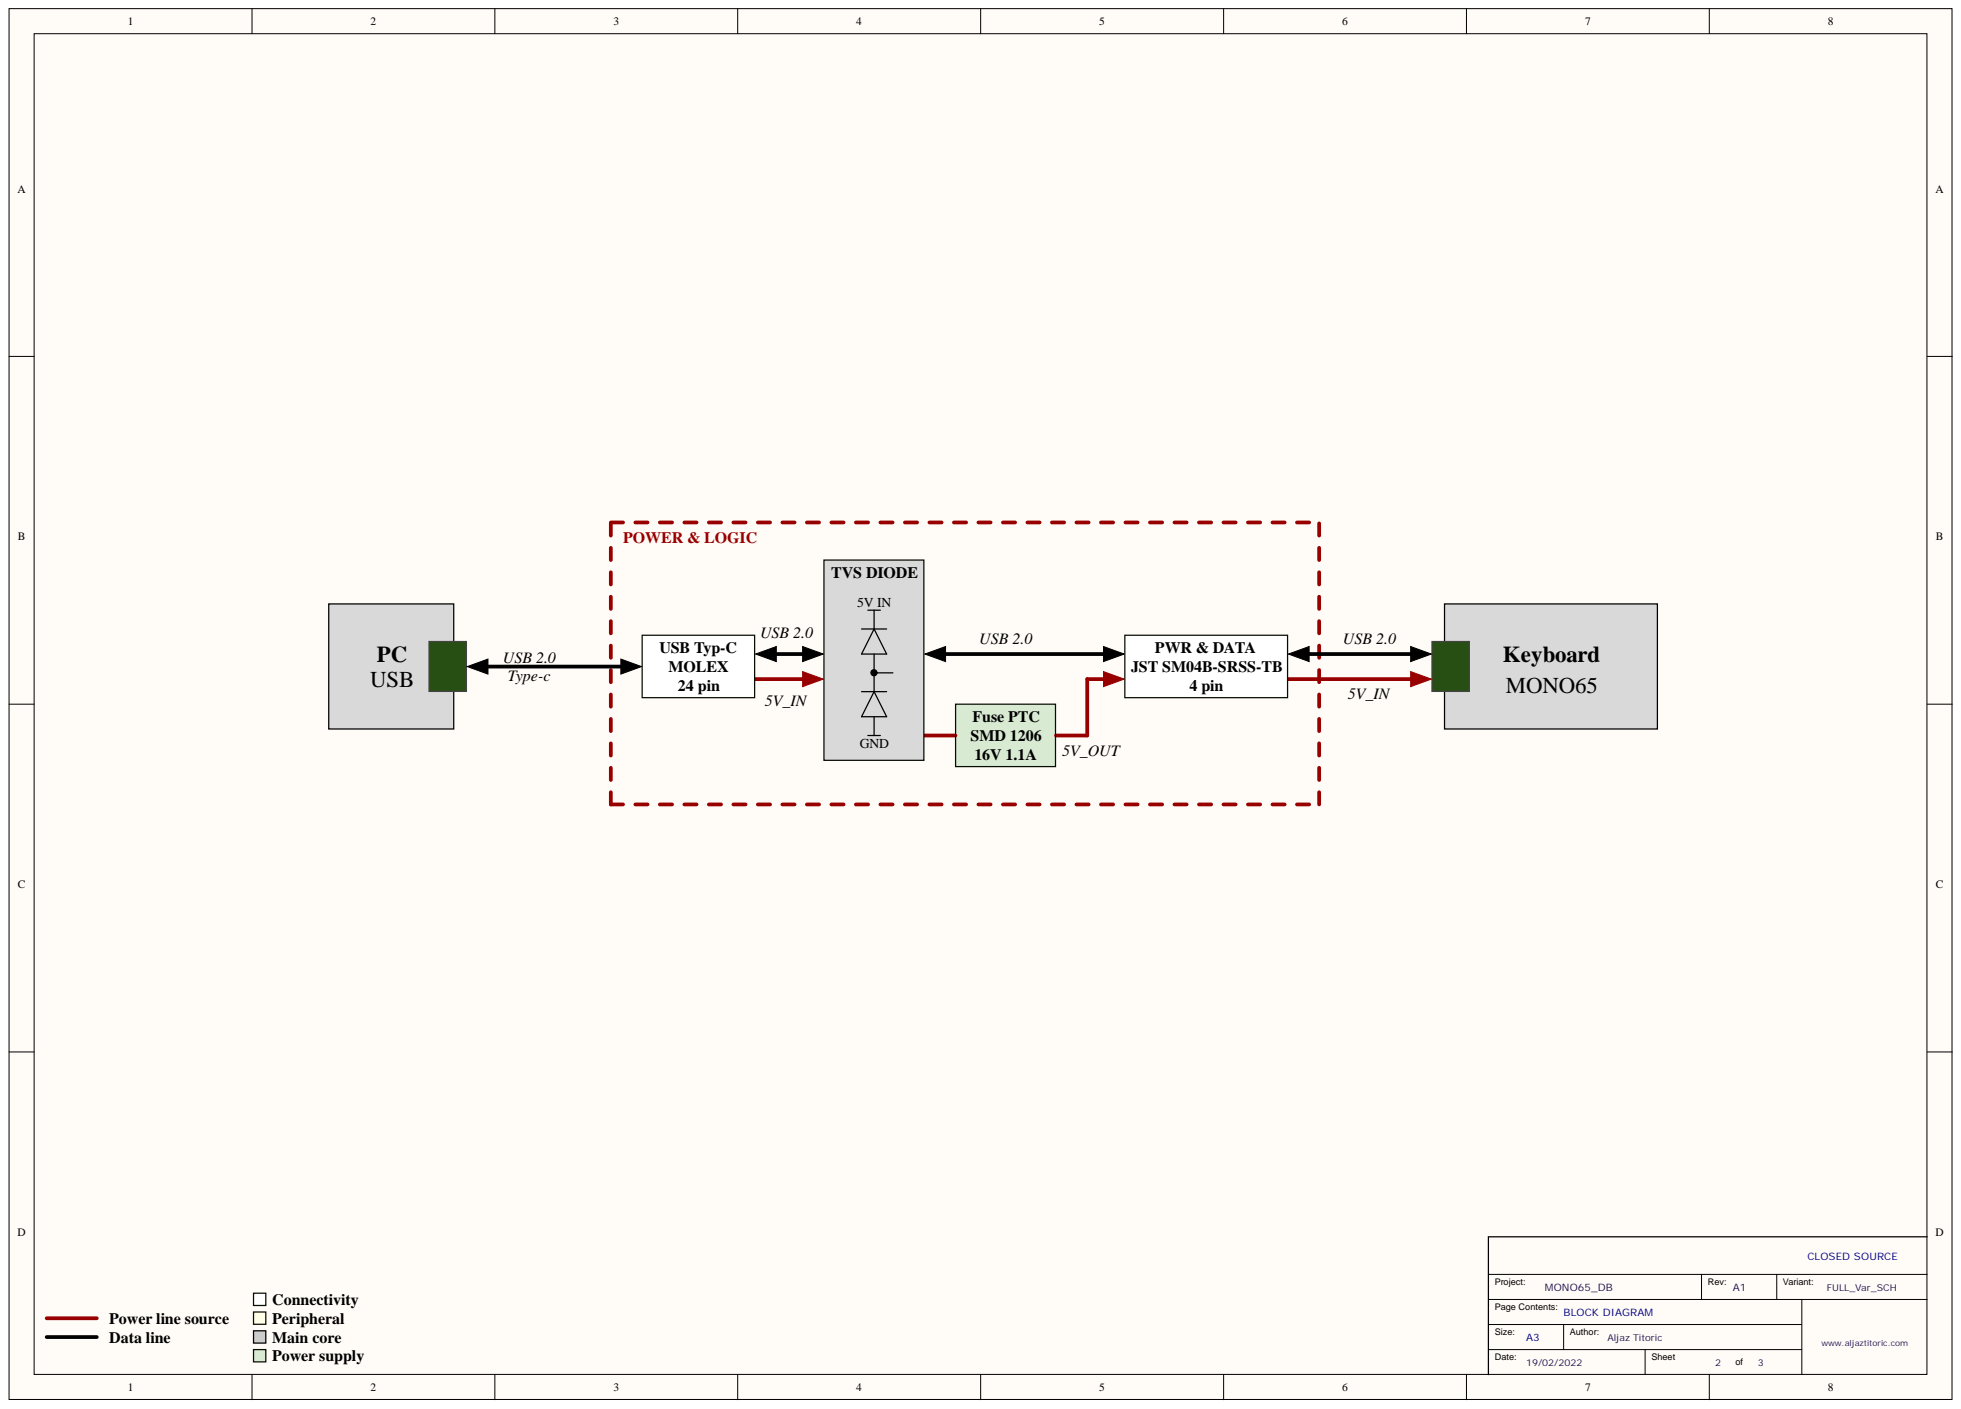
[picture p53: page 2]

Project: MONO65_DB | Rev: A1 | Variant: FULL_Var_SCH

BLOCK DIAGRAM

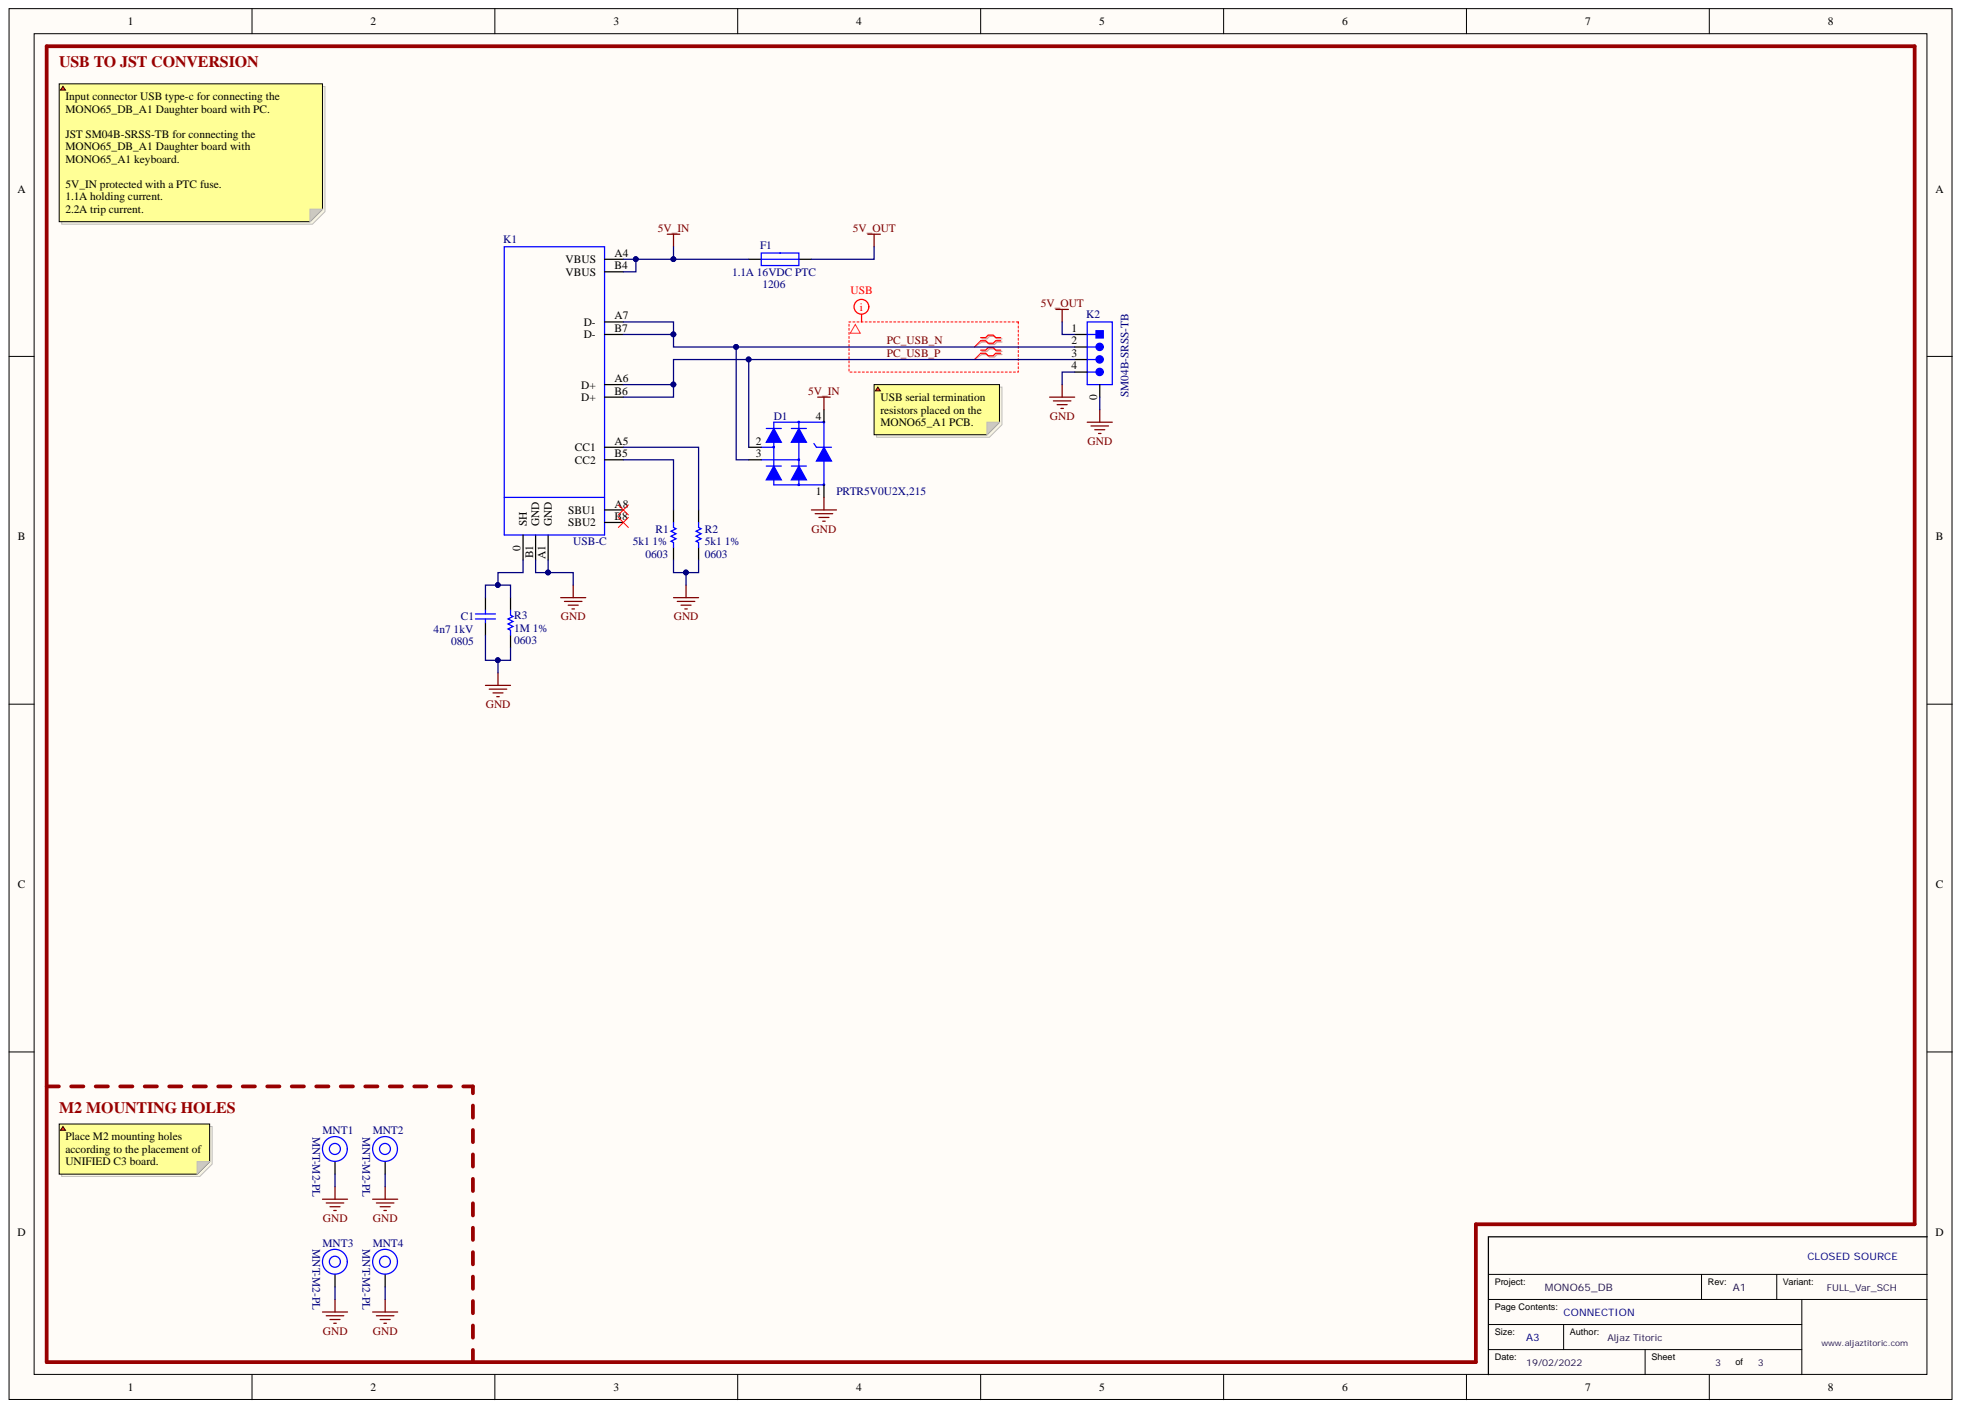
[picture p54: page 3]

USB TO JST CONVERSION

Input connector USB type-c for connecting the
MONO65_DB_A1 Daughter board with PC.

JST SM04B-SRSS-TB for connecting the
MONO65_DB_A1 Daughter board with
MONO65_A1 keyboard.

5V_IN protected with a PTC fuse.
1.1A holding current.
2.2A trip current.

PC_USB_N | | 2
PC_USB_P | 3

USB serial termination
resistors placed on the
MONO65_A1 PCB.

Place M2 mounting holes
according to the placement of
UNIFIED C3 board.

Project: MONO65_DB | Rev: A1 | Variant: FULL_Var_SCH

CONNECTION

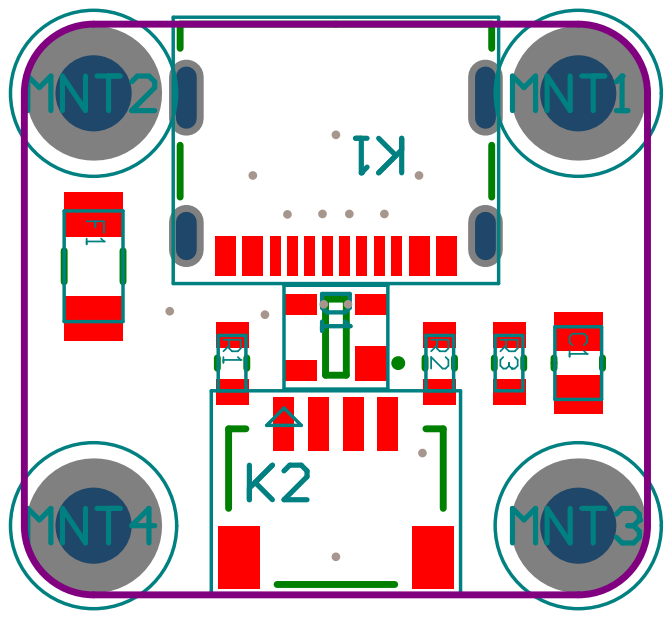
[picture p55: page 4]

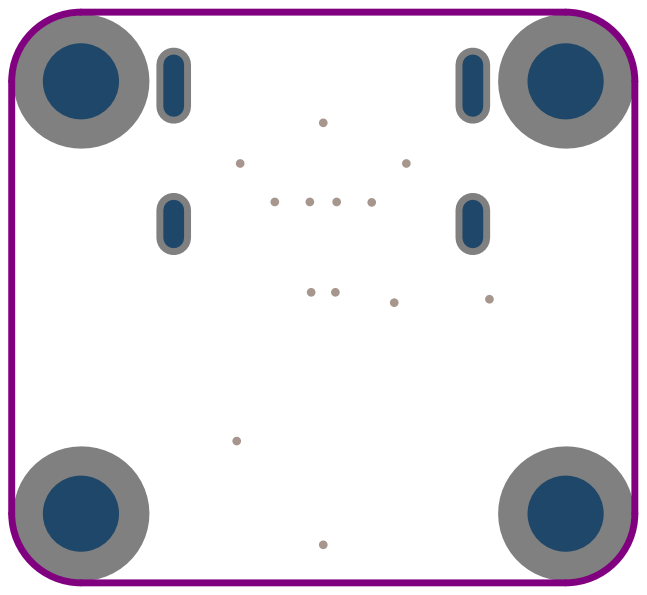
[picture p56: page 5]
