we-are-mono/keyboard/feet-gaskets/MONO65-keyboard-gasket.pdf

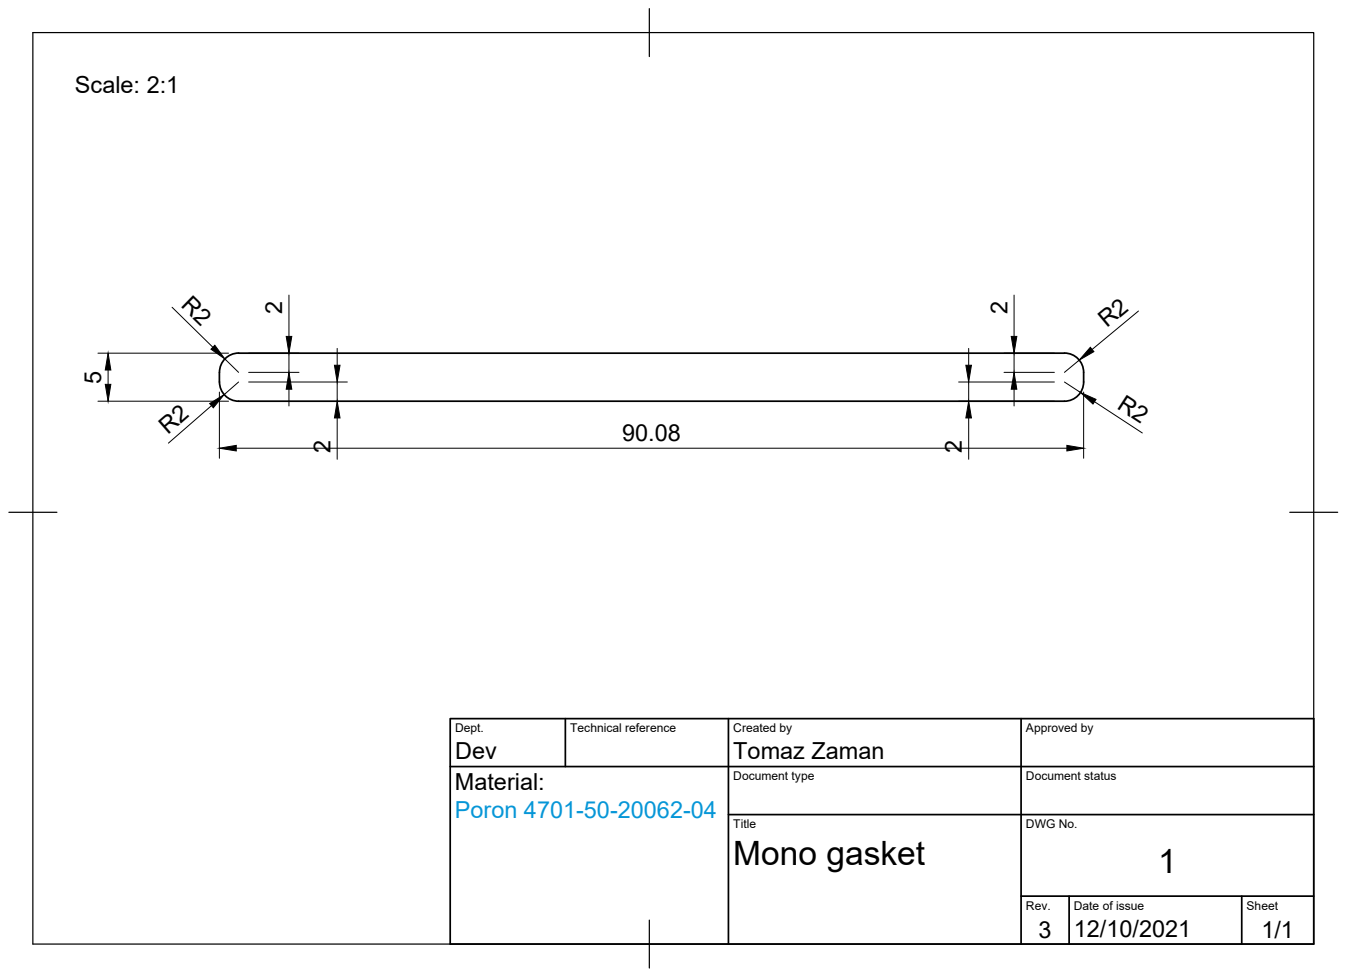
[picture p57: page 1]
Scale: 2:1

Dept. Dev | Technical reference | Created by Tomaz Zaman | Approved by

Material: Poron 4701-50-20062-04 | | Document type | Document status

Title Mono gasket | DWG No. 1

Rev. 3 | Date of issue 12/10/2021 | Sheet 1/1
