we-are-mono/keyboard/feet-gaskets/MONO65-keyboard-silicone-feet.pdf

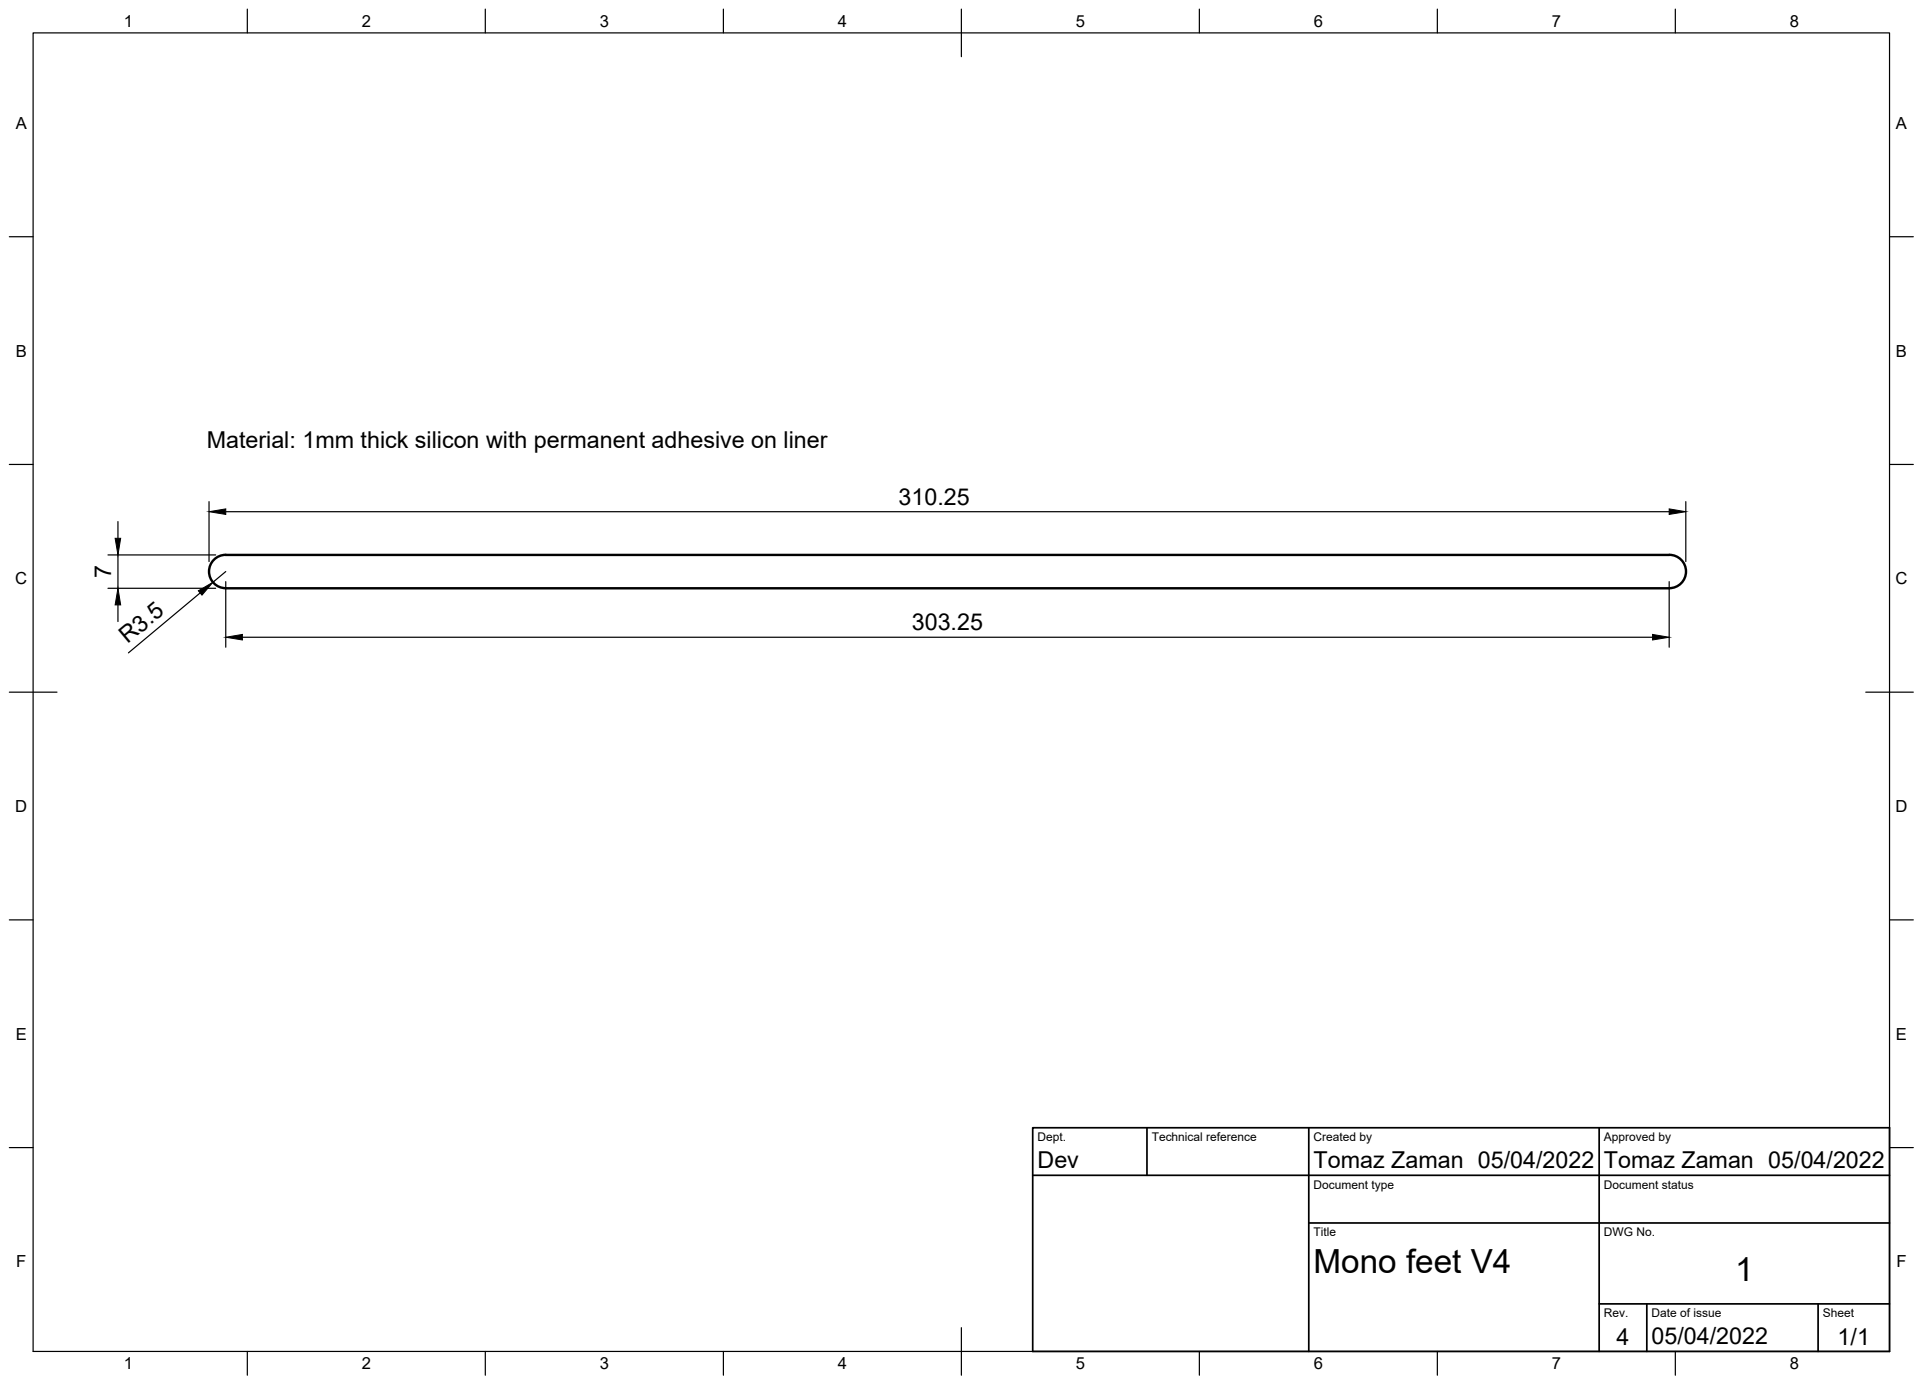
[picture p58: page 1]
Title; DWG No.; Rev.; Date of issue; Sheet; Mono feet V4

Material: 1mm thick silicon with permanent adhesive on liner

Dept. Dev | Technical reference | Created by Tomaz Zaman 05/04/2022 | Approved by Tomaz Zaman 05/04/2022

Document type | Document status
