we-are-mono/keyboard/electronics/MONO65/A2/fabricationFiles/Assembly/MONO65_A2_Assembly_NO_SWITCHES_Var_SCH/MONO65_A2_Assembly_NO_SWITCHES_Var_SCH.PDF

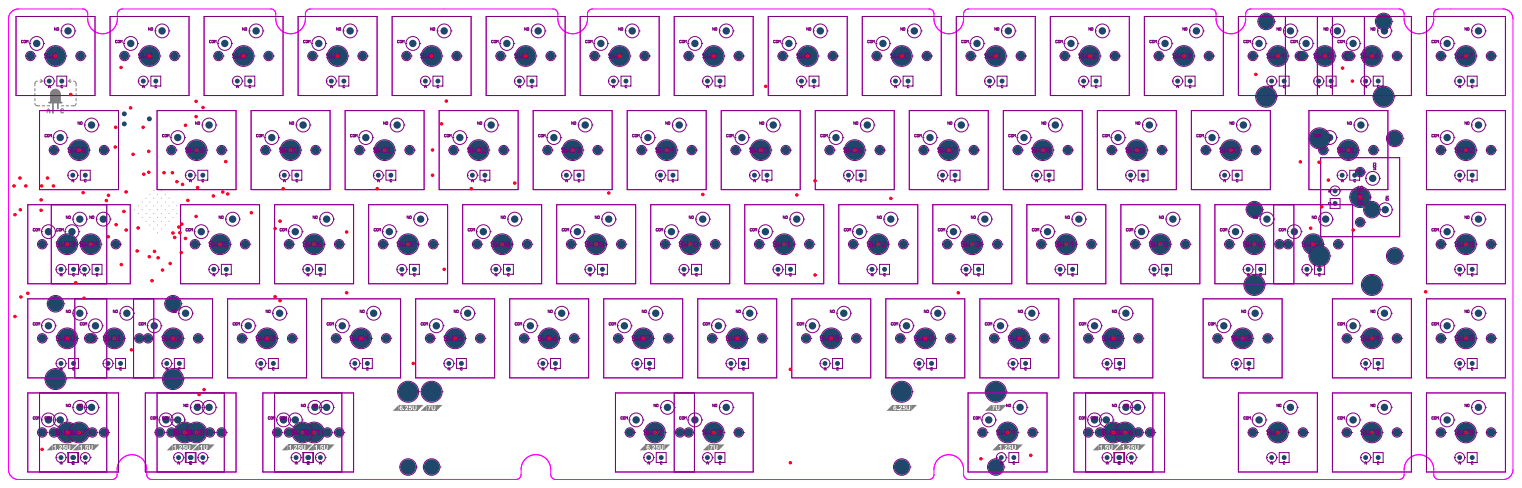
[picture p59: page 1]

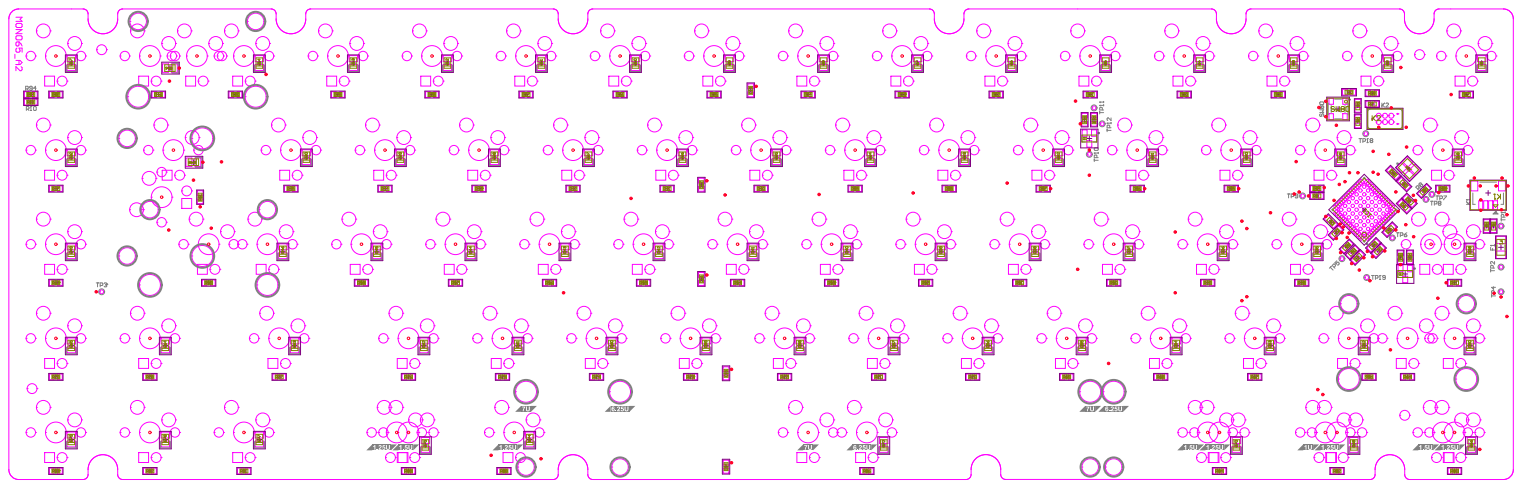
[picture p60: page 2]
