we-are-mono/keyboard/electronics/MONO65_DB/A1/fabricationFiles/Assembly/MONO65_DB_A1_Assembly_FULL_Var_SCH/MONO65_DB_A1_Assembly_FULL_Var_SCH.PDF

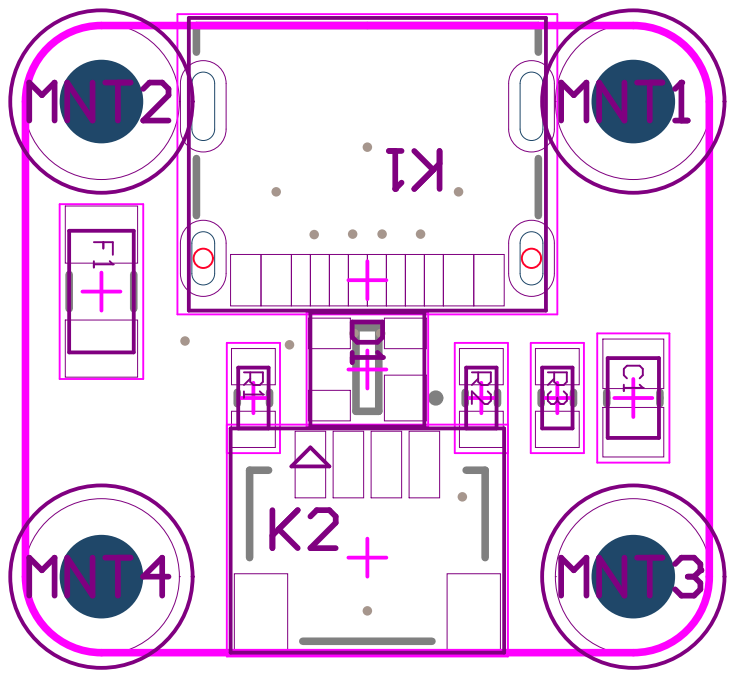
[picture p61: page 1]

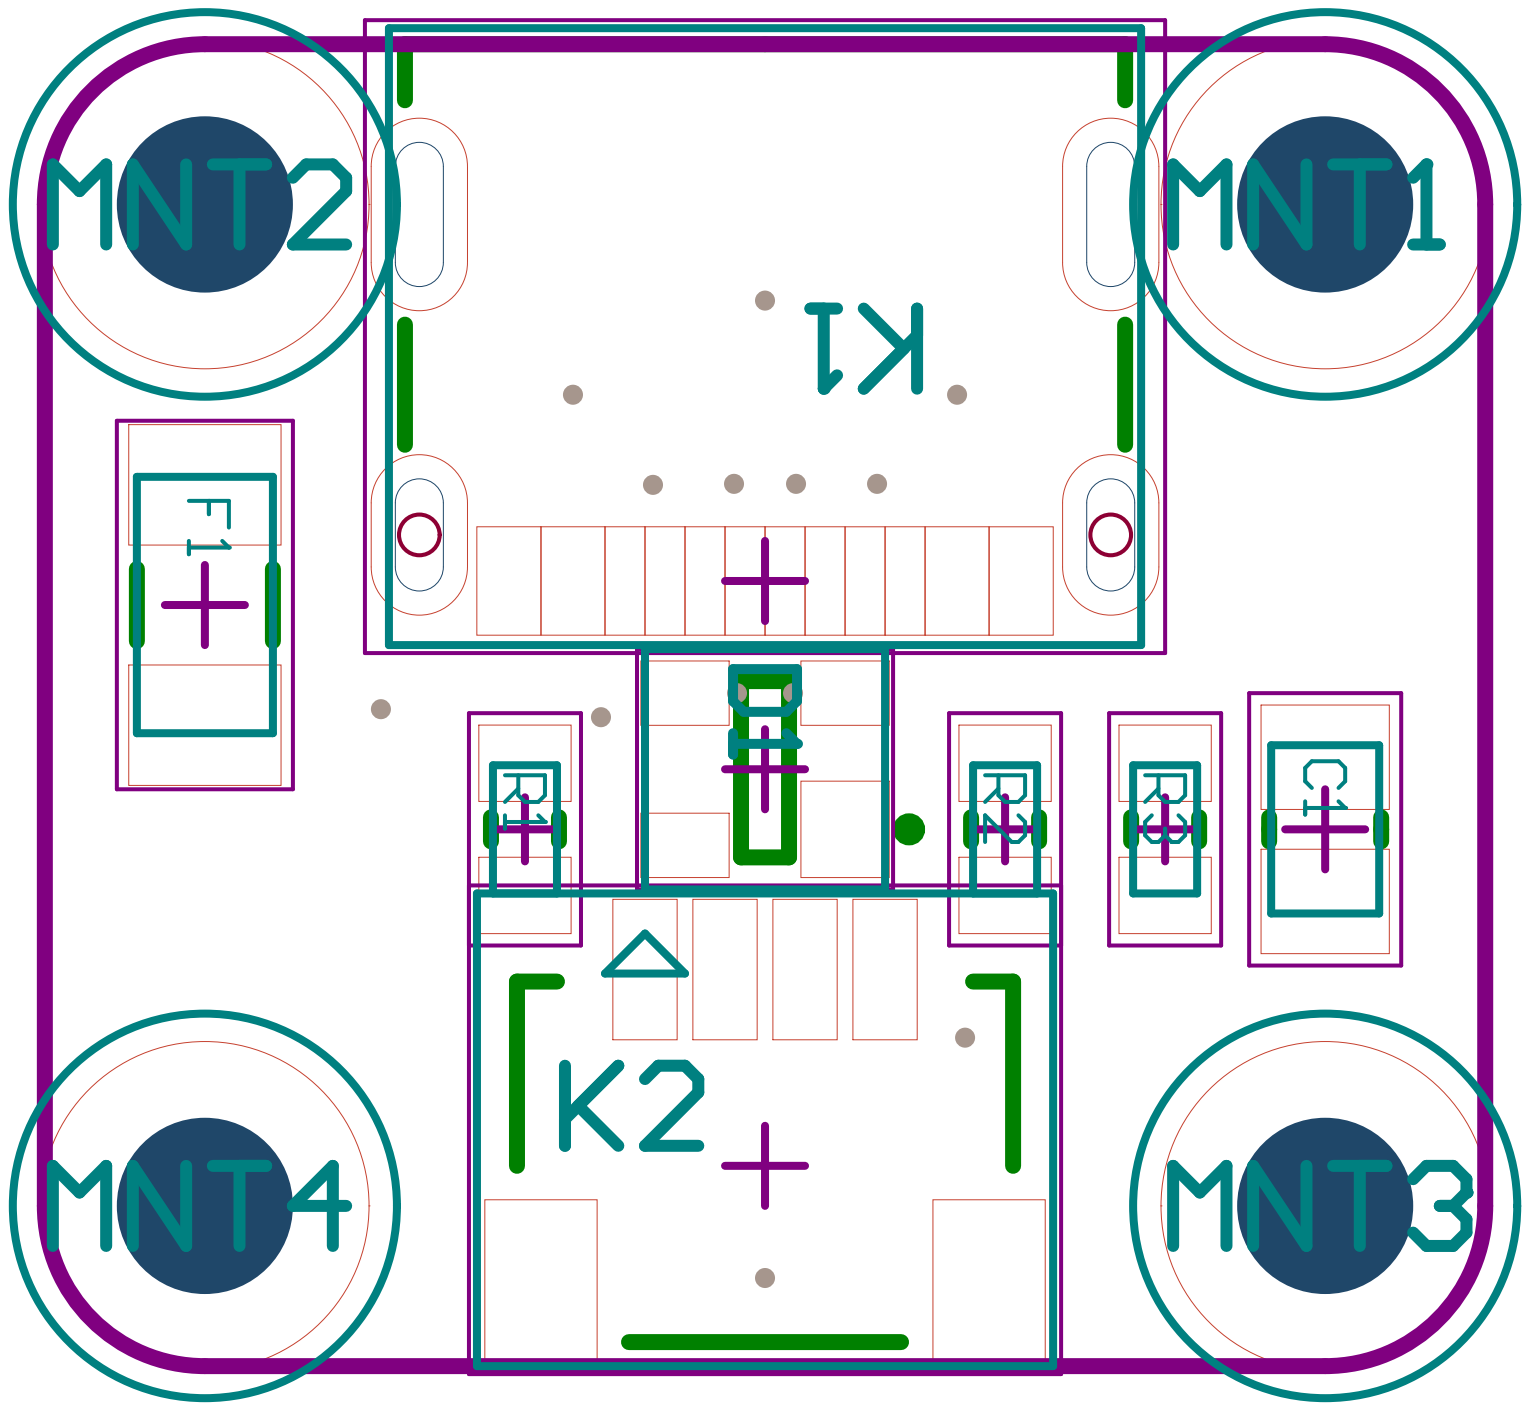
[picture p62: page 2]

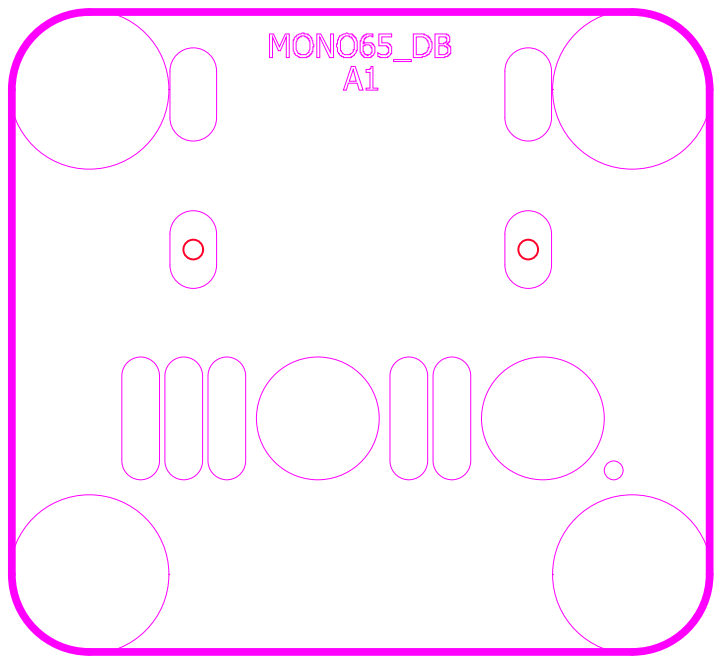
[picture p63: page 3]

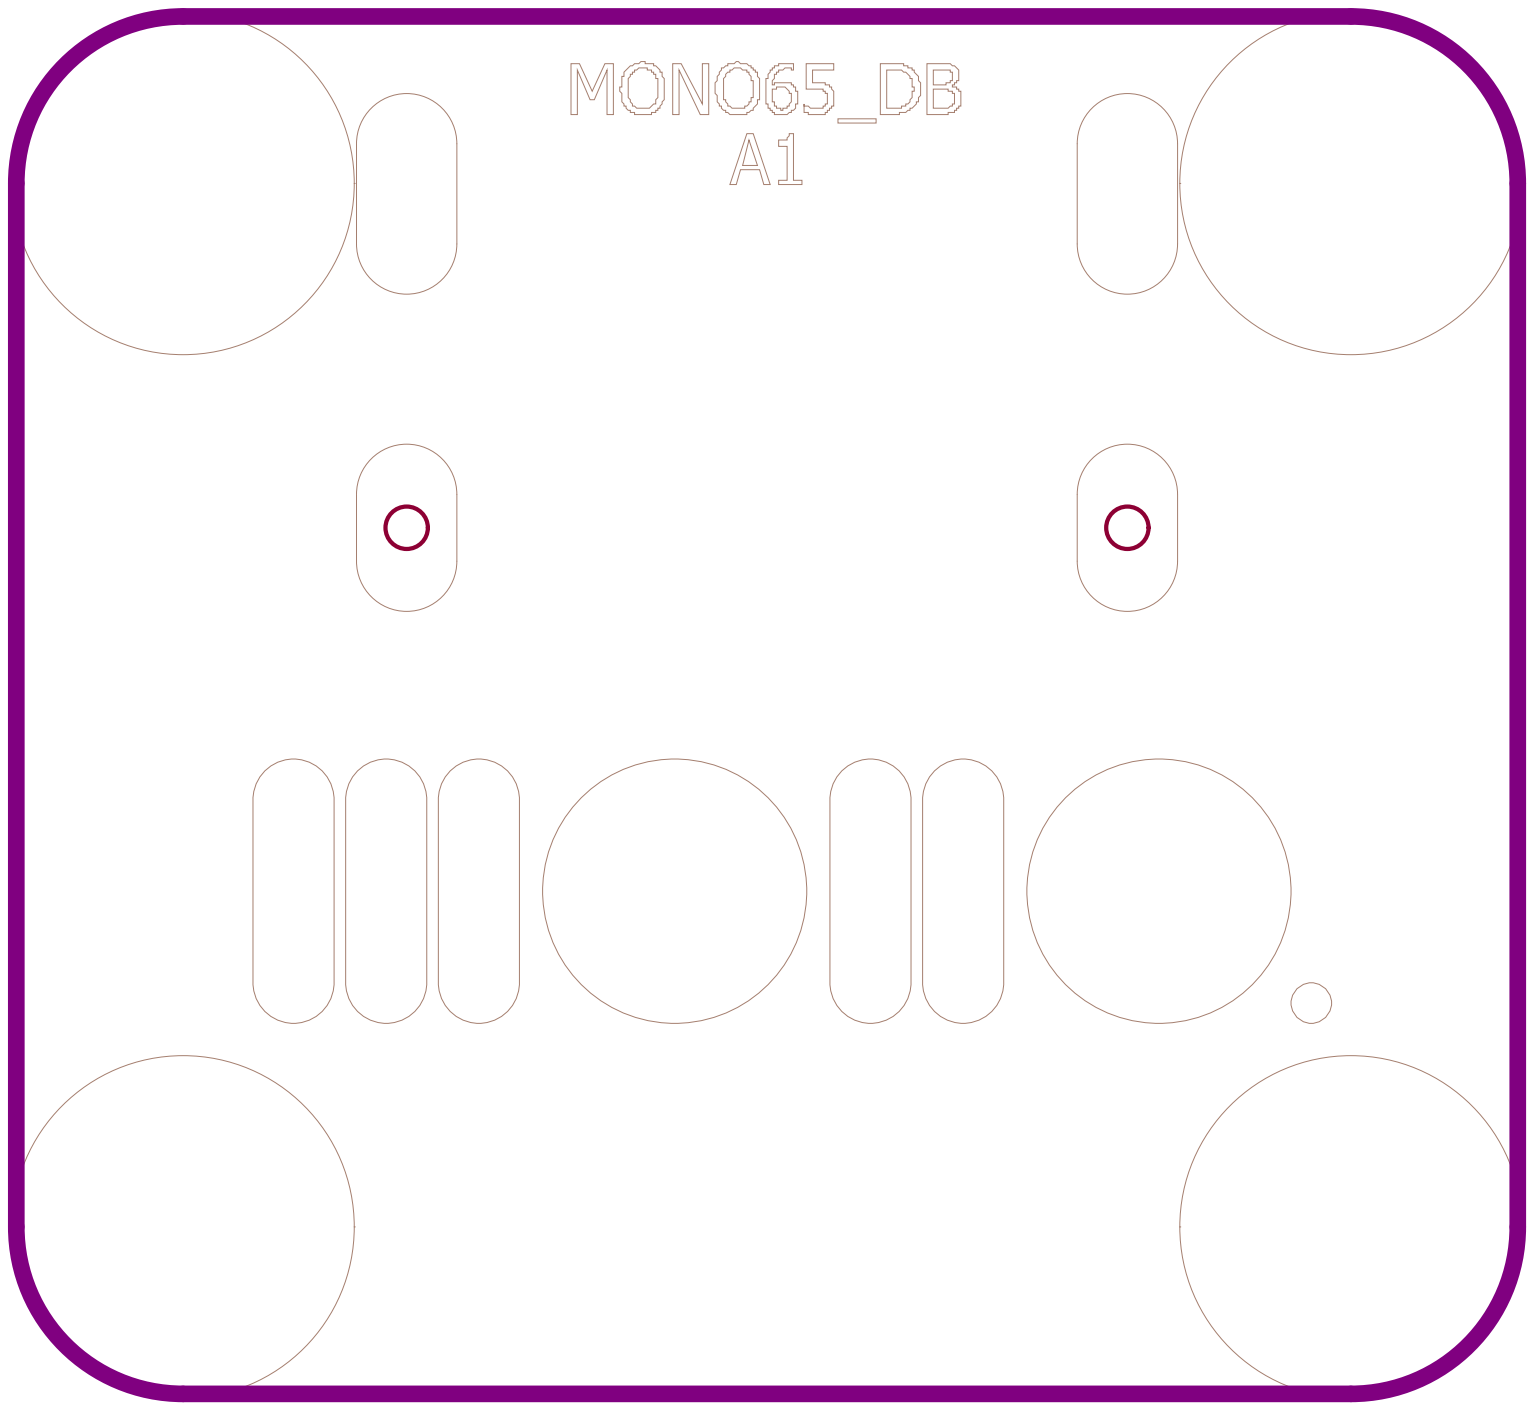
[picture p64: page 4]
