we-are-mono/keyboard/(list of files, drawings)

Other design files:
electronics/MONO65/A2/sourceFiles/MONO65_A2.PcbDoc
electronics/MONO65/A2/sourceFiles/MONO65_A2_Project.PrjPcb
electronics/MONO65/A2/sourceFiles/MONO65_A2_s01 [Main page].SchDoc
electronics/MONO65/A2/sourceFiles/MONO65_A2_s02 [Block diagram].SchDoc
electronics/MONO65/A2/sourceFiles/MONO65_A2_s03 [MCU].SchDoc
electronics/MONO65/A2/sourceFiles/MONO65_A2_s04 [Switches-1].SchDoc
electronics/MONO65/A2/sourceFiles/MONO65_A2_s05 [Switches-2].SchDoc
electronics/MONO65/A2/sourceFiles/MONO65_A2_s06 [LEDs].SchDoc
electronics/MONO65/A2/sourceFiles/MONO65_A2_s07 [PSU].SchDoc
electronics/MONO65_DB/A1/sourceFiles/MONO65_DB_A1.PcbDoc
electronics/MONO65_DB/A1/sourceFiles/MONO65_DB_A1_Project.PrjPcb
electronics/MONO65_DB/A1/sourceFiles/MONO65_DB_A1_s01 [Main page].SchDoc
electronics/MONO65_DB/A1/sourceFiles/MONO65_DB_A1_s02 [Block diagram].SchDoc
electronics/MONO65_DB/A1/sourceFiles/MONO65_DB_A1_s03 [Connection].SchDoc
electronics/MONO65_PLATE/A1/sourceFiles/MONO65_PLATE_A1.PcbDoc
electronics/MONO65_PLATE/A1/sourceFiles/MONO65_PLATE_A1_Project.PrjPcb
